RazdoruNET/DED_CORE_SPEAKER/README.md

# DED CORE SPEAKER — умная колонка и главная док-станция

Колонка на ESP32 с голосом ИИ-помощника «Лира»: микрофон, динамик, датчики,
ИК-пульт, шлюз для других умных устройств.

Документ описывает концепт и решения. Код прошивки — в [`firmware/`](./firmware),
план серверной части — в [`docs/03-server-plan.md`](./docs/03-server-plan.md)
(это план изменений в `src/AssistantService`, кода там ещё нет).

## Главное решение: колонка — тонкий терминал

Вся логика уже живёт на сервере: `AssistantService` умеет распознавать речь
(`VoiceTranscriptionService`), вести агента с инструментами (`AgentRuntime`),
синтезировать голос по фразам и отдавать его потоком (`speechChunk`), управлять
устройствами (`home.list` / `home.set`) и помнить человека. Колонке не нужен
свой интеллект — нужен качественный аудиотракт, wake word и надёжная связь.

Обратная сторона тоже верна: колонка **не должна умирать вместе с сервером**.
Поэтому целевая архитектура предусматривает три режима и переключение между ними.

## Три режима работы

| Режим | Кто «думает» | Что работает |
|---|---|---|
| **Автономный** | сама колонка | wake word + набор локальных команд, таймеры, будильники, громкость, ИК-пульт, Bluetooth-приёмник, локальные сценарии, ESP-NOW-датчики |
| **Агент** | сервер (`AssistantService`) | полный диалог, инструменты, память, управление платформой, ответ голосом потоком |
| **Сессия сайта** | браузер пользователя | колонка — это микрофон и динамик открытой вкладки: сайт ведёт разговор, колонка отдаёт звук в комнату |

Приоритет: **голосовой вызов → сессия сайта → агент → автономный**. Один владелец
звука одновременно; переключение — арбитром в прошивке
([`docs/01-architecture.md`](./docs/01-architecture.md)).

Сессия сайта важна отдельно: когда человек сидит за компьютером, второй интеллект
в колонке не нужен — она превращается в его микрофон и динамик, и голос Лиры звучит из
колонки, а не из ноутбука.

## Роль «главной док-станции»

Колонка — не просто колонка, а точка сбора умного дома:

* **ESP-NOW** — батарейные датчики (дверь, движение, температура) без Wi-Fi на каждом;
* **UART-модуль ESP32-H2** — Zigbee/Thread-координатор (вторая плата на том же корпусе);
* **ИК** — кондиционер, телевизор, вентилятор (приём и передача);
* **ммВолна LD2410C** — присутствие в комнате, без камеры;
* **MQTT-мост** — всё, что уже умеет говорить по MQTT.

Со стороны платформы колонка регистрируется как `IHomeDeviceProvider`, то есть
`home.list` и `home.set` работают с ней и её датчиками без изменения таблиц.

## Свет как язык агента

Лента — это низ лица агента: **уши (щёки)** и **рот**. 17 диодов буквой U
делятся по смыслу, а не поровну:

| Диоды | Что это | Роль |
|---|---|---|
| 1–3 и 15–17 | **уши** | индикация событий; ярче, когда колонка слышит звук |
| 4, 5 и 13, 14 | — | погашены всегда: граница между ухом и ртом |
| 6–12 | **рот** | двигается всегда — и в тишине, и во время речи |

Матрица глаз появится отдельной деталью, поэтому здесь только уши и рот.
Раскладка живёт в `firmware/src/app/LedLayout.h`.

**Рот двоичный и повторяет только голос агента.** В устойчивом виде диод либо
горит полностью, либо погашен; мягкость даёт только переход между формами.

- **Покой** — только средний диод: `0001000`.
- **Речь** — симметричные формы по центру под громкость:
  `0001000 → 0011100 → 0111110 → 1111111`.
- **Простой** — изредка (раз в 6–18 с) рот оживает: тройка диодов проезжает
  влево-вправо или пульсирует `010 → 111 → 010`.

**Шкалы микрофонов.** В простое лента показывает уровень каждого микрофона:
от диода 17 к центру — левый, от диода 1 к центру — правый. Чем громче канал,
тем длиннее шкала. Анимация речи рисуется поверх, поэтому она всегда главнее.

**Рот двигается всю речь агента.** Звук идёт либо из динамика колонки, либо из
браузера — во втором случае сервер присылает колонке огибающую той же записи,
поэтому рот работает и там, и там. Состояние «говорю» держится всю фразу,
включая паузы между слогами.

**Обращение видно сразу:** на слово-активатор вся лента на две секунды
загорается синим. Перед выполнением агент коротко отвечает голосом
(«Выполняю.») и только потом берётся за команду.

**Активация — только по слову-активатору.** Любой звук в комнате ленту не
меняет: колонка слышит постоянно, но при обращении вся лента вспыхивает синим
на две секунды, а дальше включается «слушаю». Приглушение эфира тоже
включается только здесь (`EVENT {kind:"wake"}`). Затем `thinking` — «думаю»,
и речь ответа.

**Рот повторяет реальный звук ответа**, от первого слова до последнего: когда
голос идёт из динамика — по уровню воспроизведения, когда из браузера — по
огибающей, которую сервер присылает событиями `EVENT {kind:"voice", v}`
25 раз в секунду.

**Уши — индикация событий.** В простое белое с пастельными переливами, в
раздумье бежит искра, у ошибки красное дыхание. Когда колонка слышит звук,
уши светятся тем ярче, чем громче голос.

| Состояние | Уши (1–3, 15–17) | Рот (6–12) |
|---|---|---|
| загрузка | белые точки с кончиков сходятся к центру | вспыхивает голубым огоньком |
| ждёт телефон | синие, плавное дыхание | тихое синее дыхание |
| ищу телефон | синяя искра от рта к виску | синее дыхание |
| **простой** | белое с пастельными переливами | спокойное дыхание |
| **слушаю** | бирюза, ярче с громкостью | `0001000`, без реакции на человека |
| **думаю** | фиолетовая искра по ушам | медленное фиолетовое дыхание |
| **говорю** | ровная зелень | форма по громкости, по центру |
| нет сервера | синяя искра по ушам | тлеет |
| ошибка | красное дыхание | тихое красное дыхание |
| звонок | стробоскоп | стробоскоп |
| микрофон выключен | красное дыхание | почти закрыт; перекрывает всё |

Ключевое правило: **выключенный микрофон перекрывает всё**. Человек должен
видеть это из любого угла комнаты, даже во время разговора.

Яркость ограничена 160 из 255: на 3.3 В полная яркость просаживает шину, и в
данные ленты начинают проскакивать ошибки — случайные цветные вспышки. После
перехода на 5 В с 74HCT125 яркость поднимается до 255.

Питание: лента подключена к **3.3 В** платы — так уровень данных ESP32
совпадает с лентой без согласователя. При яркости 220 из 255 17 диодов берут
около 0.45 А. Для полной яркости ленту питают от 5 В, а данные подают через
74HCT125 или диодную развязку (1N4148 + 1 кОм к +5 В).

**PSRAM выключена.** На этом ядре (Arduino 2.0.17 / IDF 4.4) связка «буферы TLS
в PSRAM + драйвер Wi-Fi» ломает память: колонка перезагружалась каждые 10–20
секунд. Без PSRAM — стабильная работа. Подробности и что поправить, чтобы
вернуть её: [`docs/05-firmware.md`](docs/05-firmware.md#почему-psram-выключена).

Для боевого `dedbox.pro` собирайте `esp32s3_dedbox`: сервер подписан
Let's Encrypt, и к CA платформы добавляется ISRG Root X2. Обычный `esp32s3`
остаётся для стенда с собственным CA.

## Железо: что выбрано и чего ждать

Основа — **ESP32-WROOM-DA** (классический ESP32, 520 КБ SRAM, без PSRAM).
Это рабочая база для прототипа: wake word (MicroWakeWord на TFLite Micro),
VAD, Opus, ИК, ESP-NOW, датчики — помещаются.

Не помещаются одновременно: аппаратный AEC (в esp-sr 2.x только S3+PSRAM),
декодирование музыки, дуплексный голосовой вызов. Подробный разбор с цифрами —
[`docs/04-hardware-bom.md`](./docs/04-hardware-bom.md). Прошивка пишется с
профилями `DA` и `S3`, чтобы переход на `ESP32-S3-WROOM-1 N16R8` был сборкой
другого env, а не переписыванием.

## Что лежит в папке

```
smart-speaker/
├── README.md                    этот файл: концепт и решения
├── LICENSE                      лицензия (некоммерческая, см. ниже)
├── LICENSE_EN                   то же на английском
├── docs/
│   ├── 01-architecture.md       слои, режимы, арбитр звука, топологии хаба
│   ├── 02-audio-protocol.md     бинарный WebSocket, кадры, кодеки, тайминги
│   ├── 03-server-plan.md        что добавить в AssistantService (файлы, ручки, конфиг)
│   ├── 04-hardware-bom.md       BOM, распиновка, питание, тепло, путь на S3
│   ├── 05-firmware.md           задачи FreeRTOS, бюджет памяти, состояния, OTA
│   ├── 06-roadmap.md            этапы, метрики приёмки, риски
│   ├── 07-pairing-security.md   первая синхронизация с аккаунтом, модель угроз
│   ├── 08-pairing-ux.md         сценарий привязки для человека
│   └── 09-production-security.md что обязательно сделать для серийной платы
├── firmware/                    PlatformIO-проект (собирается: pio run -e esp32da)
├── stl/                         файлы для 3D-печати корпуса колонки
└── tools/                       проверки протокола (векторы вывода ключа)
```

Локальный стенд (`.dev/` рядом с этим файлом; в основном репозитории —
`smart-speaker/.dev/`) и `firmware/src/config/Secrets.h` в публикацию не
входят: там приватные ключи, сертификаты и код привязки макета.
Правила — в `.gitignore` рядом с этим файлом.

## Два репозитория: платформа и колонка

Эта папка — копия содержимого отдельного репозитория изделия
[`RazdoruNET/DED_CORE_SPEAKER`](https://github.com/RazdoruNET/DED_CORE_SPEAKER):
там `smart-speaker/` лежит в корне. Правки прошивки и документации нужно
отправлять в оба, иначе версии расходятся — свежая прошивка остаётся в
платформе, а на странице изделия висит старая.

Как это делается здесь:

```bash
# 1. обычный коммит в основную платформу
git -C ~/Documents/GitHub/ded-core-platform commit ...

# 2. то же содержимое — в репозиторий колонки
rsync -a --delete \
  --exclude '.git' --exclude '.pio' --exclude '.DS_Store' \
  --exclude 'Secrets.h' --exclude '.dev' --exclude '.github' \
  smart-speaker/ /tmp/DED_CORE_SPEAKER/ && \
  git -C /tmp/DED_CORE_SPEAKER add -A && \
  git -C /tmp/DED_CORE_SPEAKER commit -m "..." && \
  git -C /tmp/DED_CORE_SPEAKER push origin HEAD:main
```

`.github` исключён намеренно: в репозитории изделия workflow обновляется
Dependabot, и копия из платформы откатила бы его назад.
`Secrets.h` и `.dev/` не попадают в git ни там, ни там — это правило
проверяет CI (`hygiene` в `security.yml`).

## Корпус: файлы для печати

В каталоге [`stl/`](./stl) лежат готовые к печати модели корпуса колонки —
здесь будут собраны **все** файлы, нужные, чтобы напечатать такой корпус
целиком (`Body2.stl` — основание/корпус; остальные детали добавляются по мере
готовности). Печатать в том же масштабе, что и модель (1:1, единицы —
миллиметры), без автоподгонки под стол принтера.

Что учесть при печати:

* материал — PETG или ASA: PLA рядом с усилителем и закрытым объёмом течёт
  уже при 55–60 °C;
* микрофоны встают на демпферы в верхней части корпуса, динамик — в
  ФИ-корпус с портом 25×60 мм; зазоры и посадки описаны в
  [`docs/04-hardware-bom.md`](./docs/04-hardware-bom.md);
* файлы — только геометрия, крепёж, экраны и прокладки в них не входят.

## Быстрый старт прошивки

```bash
cd smart-speaker/firmware
pio run -e esp32da            # сборка под ESP32-WROOM-DA
pio run -e esp32da -t upload  # прошивка
pio device monitor -b 115200

# Проверка усилителя MAX98357A и динамика без сети: три тона при старте
pio run -e esp32da_spk -t upload   # для esp32s3 — esp32s3_spk
```

Настройка — **только по Bluetooth, без точки доступа и без веб-интерфейса на
устройстве**. Своего фронта у колонки нет вовсе: настройка живёт на сайте
(Web Bluetooth), Wi-Fi и привязка приезжают в зашифрованном кадре. Это снимает
главное ограничение 4 МБ флеша и убирает целый класс уязвимостей «страница
настройки на устройстве».

Порядок: профиль → «ИИ Агент» → «Добавить колонку» → код с наклейки →
выбор колонки в списке Bluetooth → готово. Механика и модель угроз —
[`docs/07-pairing-security.md`](./docs/07-pairing-security.md).

## Состояние разработки

* **Версия прошивки — 0.2.3:** три встроенных слова-активатора, офлайн-набор
  домашней колонки и гоночная гарнитура отдельной сборкой `esp32s3_intercom`.
  В 0.2.2 закрыт откат версии кадра привязки, преролл сбрасывается при остановке
  захвата, а слабый голос больше не проходит проверку «по умолчанию».
  В 0.2.3 ограничена мощность Wi-Fi-передатчика: на слабом порту USB колонка
  больше не уходит в `BROWNOUT_RST` в момент подключения к сети.
* **Проверено на прототипе:** сборка и прошивка ESP32-WROOM-DA, стабильный
  идентификатор, ключ P-256 и криптосамопроверка, BLE-сервис, ручное окно
  сопряжения, RGB-состояния в коде, основы I2S/VAD.
* **Привязка проверена сквозным тестом на железе:** кадр шифруется независимой
  реализацией (ECDH → HKDF → AES-256-GCM), подпись сервера проверяется на
  устройстве, настройки сохраняются, подпись чужим ключом отвергается.
* **Сервер:** подпись grant, сущности `SpeakerDevices`/`SpeakerPairings`,
  миграция, ручки `pair/claim`, `devices`, `unbind`, `report-stolen`, `rename`
  и WebSocket `/api/assistant/speaker/stream` с fail-closed аутентификацией.
* **Защита сервера от открытого протокола:** лимит одновременных соединений
  (256 всего, 8 с адреса), 120 неудачных попыток HELLO в час с адреса, реальный IP за
  шлюзом (`UseForwardedHeaders`), сверка `pub` из `HELLO` с отпечатком привязки
  до выдачи `deviceKey`, закрепление отпечатка только после WSS-подключения.
* **Микрофон:** mute останавливает захват в прошивке и отбрасывается сервером;
  красная лента перекрывает любое состояние.
* **Безопасность канала:** колонка принимает только HTTPS/WSS и доверяет **только
  CA платформы** (`SPEAKER_ROOT_CA_PEM`), то есть сервер запинен. Публичные корни
  подмешиваются лишь флагом сборки `SPEAKER_ALLOW_PUBLIC_ROOTS=1` — вместе с ними
  доверие расширяется до любого публичного CA, и подделать сервер сможет тот, кто
  получит у него сертификат на наш домен (в HELLO уходит ключ устройства). Этот флаг —
  только для стенда. Если CA не задан, соединение блокируется намеренно; проверено
  на устройстве.
* **Встроенный набор и вариант устройства:** в прошивке есть таблица фраз
  домашнего устройства — три слова-активатора («Лира», «Джарвис», «Колонка») и
  две команды света («включи свет», «выключи свет»). Вариант
  (`SPEAKER_ROLE_HOME` / `SPEAKER_ROLE_INTERCOM`) задаётся при сборке. Гоночная
  гарнитура — отдельное изделие на общей базе: у неё своя сборка `esp32s3_intercom` и
  свой набор команд, команд света домашней колонки в нём нет. Пилот надевает её, чтобы
  в гонке не снимать руки с руля: голосом — зажигание и карты. Акустическое
  распознавание ещё не подключено, поэтому сейчас работают таблица и
  маршрутизация, а свет — заглушка без железа.
* **В разработке:** физическая сборка аудиотракта, стриминговый STT, звук по
  бинарному каналу.
* **Не реализовано:** wake word, Opus, датчики, ИК, OTA-клиент, локальные
  сценарии, автономное распознавание команд.
* **Остаточные риски** (привязка кадром версии 1 на устройстве без кода,
  нешифрованная NVS макета, перебор кода при утечке базы) перечислены в
  [`docs/07-pairing-security.md`](./docs/07-pairing-security.md), требования к
  серии — в [`docs/09-production-security.md`](./docs/09-production-security.md).

## Журнал изменений

### 0.2.3

* **Потолок мощности Wi-Fi 11 дБм.** Пиковый ток передатчика — главная нагрузка
  на шине 5 В. На слабом порту USB или длинном тонком кабеле просадка уходила
  ниже порога детектора, и колонка перезагружалась ровно в момент подключения к
  сети (`BROWNOUT_RST`), а вместе с перезагрузками терялись настройки в NVS.
  Потолок задаётся `SPEAKER_WIFI_TX_POWER` в `config/AppConfig.h`.
* **Стадии BLE-привязки пишутся в порт** (`[ble] стадия …`): окно привязки живёт
  пять минут, а причина отказа раньше была видна только в браузере.

### 0.2.2

* **Закрыт откат версии кадра привязки.** Версию теперь определяет сервер по
  записи устройства, она входит в подписанный grant, а сайт берёт её оттуда, а не
  из неаутентифицированной характеристики BLE. Подставное устройство больше не
  может навязать схему без кода с наклейки и прочитать пароль Wi-Fi.
  **Новая привязка требует прошивки 0.2.2:** старая каноническая строка grant
  изменилась.
* **Преролл сбрасывается при остановке захвата.** Голос агента из динамика больше
  не приклеивается к началу команды, а после mute на сервер не уходит звук,
  записанный при выключенном микрофоне.
* **Проверка голоса — эвристика, и теперь fail-closed.** Если голосовых кадров
  слишком мало, команда отклоняется, а не проходит «по умолчанию».
* **Образы DIY проверяются по SHA-256** до записи во флеш.
* **Зависимости:** `Microsoft.Data.Sqlite` 9.0.22 — закрыт GHSA-2m69-gcr7-jv3q.

### 0.2.1

* **Длинные фразы больше не теряются.** Раньше предел фразы считался по числу
  громких кадров, и в шумной комнате кусок растягивался на 20–40 с, а сервер
  выбрасывал всё длиннее 9 с. Теперь фраза ограничена по полному времени, а
  сервер обрезает слишком длинный фрагмент до последних секунд, а не удаляет.
* **«Чих» не запускает задачу ассистенту.** Детектор срабатывал на музыку, стук
  и хлопки; ответы на чих выключены по умолчанию (`Assistant:Speaker:SneezeReplies`).
* **Обращение распознаётся надёжнее.** Имя помощника и встроенные слова уходят в
  подсказки распознавания — в шуме они терялись первыми.
* **Детектор речи сбрасывается** при остановке захвата: после речи агента звук
  больше не склеивается с предыдущей фразой.

### 0.2.0

* **Три встроенных слова-активатора:** «Лира», «Джарвис», «Колонка».
* **Офлайн-набор домашней колонки:** две команды света («включи свет»,
  «выключи свет»); свет пока заглушка — реле и ламп в схеме нет.
* **Гоночная гарнитура — отдельное изделие** на общей базе прошивки: своя сборка
  `esp32s3_intercom` и образ `DED_CORE_INTERCOM_S3.bin`, домашних команд света
  в нём нет. Гарнитура нужна пилоту в гонке: руки на руле, голосом — зажигание
  и карты.
* **Сервер принимает встроенные обращения** наравне с именем профиля.
* Акустическое распознавание фраз ещё **не подключено**: работают таблица фраз
  и маршрутизация действий, проверить команды голосом нельзя.

### 0.1.0

* Привязка по BLE с кодом с наклейки.
* WSS с пином CA платформы.
* `HELLO`/`STATE` как основа протокола.
* Микрофон с VAD.
* Речь агента по `SAY`.
* Лента состояний.

## Лицензия

Прошивка, документация и описания протоколов распространяются по
некоммерческой лицензии из [`LICENSE`](./LICENSE) (English — `LICENSE_EN`):
личное и учебное использование разрешено, коммерческое — только с письменного
разрешения, производные версии — под той же лицензией. Это не OSI-лицензия.

## Что уже есть в платформе и переиспользуется

Пути в таблице — из основного репозитория платформы, здесь публикуется только
сама колонка; они показывают, какие серверные части уже готовы.

| Есть | Файл | Что даёт колонке |
|---|---|---|
| STT | `src/AssistantService/Services/Voice/VoiceTranscriptionService.cs` | распознавание фраз |
| TTS + поток по фразам | `SpeechStreamChunker.cs`, `LiveSpeechStream.cs` | первая фраза звучит до конца ответа |
| Агент | `Services/AgentRuntime.cs` | голос — ещё один клиент |
| Умный дом | `Services/Home/HomeContracts.cs` | `IHomeDeviceProvider` для колонки |
| OTA, ключи устройств | `src/FirmwareService` | обновление и привязка |
| Провижининг, LittleFS-фронт | `DED_CORE_V4-feature-ota-server-update/` | те же паттерны настройки |

Не переиспользуется только одно: **SignalR-хаб** (`speechChunk` идёт текстом JSON).
Для колонки нужен отдельный бинарный WebSocket — JSON-обёртка на каждый 20-мс
аудиокадр съедает и канал, и RAM. Обоснование — в
[`docs/02-audio-protocol.md`](./docs/02-audio-protocol.md).
