RazdoruNET/DED_CORE_SPEAKER/docs/05-firmware.md

# Прошивка

Проект — [`firmware/`](../firmware), PlatformIO, фреймворк Arduino (как в
`DED_CORE_V4`, чтобы переиспользовать провижининг, NVS и OTA-паттерны).

```
firmware/
├── platformio.ini
└── src/
    ├── main.cpp
    ├── config/AppConfig.h        пины, лимиты, профиль платы
    ├── proto/Protocol.h          кадры: типы, сборка/разбор (заголовочный)
    ├── audio/AudioPipeline.*     I2S вход/выход, преролл, VAD, оценка уровня
    ├── net/DeviceConfig.*        NVS: Wi-Fi, ключ устройства, сервер
    ├── net/DeviceIdentity.h      id устройства из MAC (он же на наклейке)
    ├── net/PairingCrypto.*       ключ P-256, расшифровка кадра привязки
    ├── net/BlePairing.*          GATT-сервис привязки и окно видимости
    ├── net/WifiLink.*            подключение к домашней сети, backoff
    ├── net/SpeakerLink.*         WS-клиент, протокол, состояние связи
    ├── app/AudioArbiter.*        кто владеет микрофоном и динамиком
    ├── app/Ui.*                  LED, кнопки, жесты
    ├── app/LedLayout.h           раскладка ленты по низу колонки (U)
    ├── app/Role.h                вариант устройства: домашняя колонка или гоночная гарнитура
    ├── app/LocalCommands.*       встроенный офлайн-набор фраз этого варианта устройства
    └── app/Intents.*             локальные команды и таймеры без сервера
```

## Задачи FreeRTOS

| Задача | Ядро | Приоритет | Стек | Что делает |
|---|---|---|---|---|
| `mic_task` | 1 | 10 | 4096 | I2S DMA → кадр 20 мс → преролл → VAD → очередь вверх |
| `wake_task` | 1 | 8 | 6144 | MFCC + TFLM каждые 20 мс по 0.6 с окну |
| `uplink_task` | 0 | 6 | 4096 | Opus-энкод + отправка кадров `MIC` |
| `downlink_task` | 0 | 7 | 6144 | приём кадров, джиттер, Opus-декод → I2S |
| `link_task` | 0 | 5 | 4096 | Wi-Fi/WS/BLE: состояние, ping, реконнект, привязка, OTA |
| `app_task` | 1 | 3 | 4096 | автомат, LED, кнопки, таймеры, ИК |

Почему именно так: аудио и wake word на одном ядре (метки времени I2S не
пересекаются с сетевыми всплесками), а сеть и декод — на втором. Классический
ESP32 без PSRAM не прощает копирования больших буферов — все передачи через
указатели и фиксированные пулы, ни одного `std::string` в аудиотракте.

## Состояния

```
BOOT → PAIRING (нет Wi-Fi/ключа, окно привязки) ──кадр принят──► перезагрузка → IDLE
IDLE ──wake word / кнопка──► LISTENING
LISTENING ──тишина 400 мс──► THINKING
THINKING ──первый кадр SAY──► SPEAKING
SPEAKING ──SPEECH_END──► IDLE
SPEAKING ──"стоп" / barge_in──► IDLE (поток закрыт)
Любое ──потеря связи──► OFFLINE (локальные умения) ──связь──► IDLE
Любое ──CMD intercom.incoming──► INTERCOM
```

Строка `THINKING` живёт не дольше `MaxDeviceSeconds` (30 с). Дольше — колонка
говорит заранее синтезированной фразой «сервер не отвечает» и уходит в `IDLE`,
а не висит в тишине.

## Тайминги, зашитые в прошивку

| Параметр | Значение | Почему |
|---|---|---|
| кадр I2S | 20 мс | совпадает с Opus-кадром, нет перепаковки |
| преролл | 0.9 с | wake word срабатывает с задержкой — начало фразы не должно потеряться |
| тишина до конца фразы | 400 мс | 900 мс (как в браузере) колонка воспринимает как «тупит» |
| минимальная фраза | 250 мс | короче — это кашель, а не команда |
| джиттер вниз | 3 кадра | 60 мс, дальше слышны провалы |
| ping | 15 с | дешевле, чем ловить зависший TCP по таймауту ответа |
| реконнект | 2 с → ×2 → 60 с | не долбить сервер при массовом отключении питания |

## NVS (namespace `spreaker`)

| Ключ | Тип | Смысл |
|---|---|---|
| `wifi_ssid` / `wifi_pass` | string | сеть |
| `api_base` | string | адрес платформы (`https://api...`) |
| `device_key` | string | ключ из профиля, вводится кодом привязки |
| `name` / `room` | string | «Колонка», «Гостиная» |
| `volume` | u8 | 0–100 |
| `mute` | bool | тумблер + софт |
| `rules_ver` | u32 | версия локальных сценариев |
| `rules` | blob | до 4 КБ — сценарии автономного режима |
| `ir_codes` | blob | обученные ИК-коды |
| `timer_*` | u32 | активные таймеры и будильники |

Ничего, что меняется чаще раза в минуту, в NVS не пишется: у ESP32 флеш
изнашивается, а `Preferences.put*` на каждом кадре убил бы её за месяцы.
Громкость пишется с задержкой 5 с после последнего изменения.

## OTA

Два слота по 1.4 МБ, `otadata` выбирает активный. Обновление — через
`FirmwareService`, тот же путь, что у DED CORE V4:

1. `EVENT {kind:"ota.available", version, url, sha256}` или ручка
   `POST /api/update` при провижининге;
2. скачивание в неактивный слот по HTTPS с проверкой SHA-256;
3. `esp_ota_set_boot_partition` + перезагрузка;
4. если после перезагрузки нет `HELLO_ACK` 3 раза подряд — откат на прежний слот
   (`esp_ota_mark_app_invalid_rollback_and_reboot`).

Ключевое отличие от DED CORE: **нельзя** обновляться, пока идёт разговор.
`link_task` дожидается `IDLE` или прерывает разговор честной фразой.

### Версии

Текущая версия — **0.2.2** (`SPEAKER_FIRMWARE_VERSION` в `config/AppConfig.h`),
она же уходит в `HELLO`. В 0.2.2 закрыт откат версии кадра привязки, сбрасывается
преролл и ужесточена проверка голоса; в 0.2.1 исправлены длинные фразы и ложные
ответы на чих. В 0.2.0 вошли три встроенных слова-активатора
(«Лира», «Джарвис», «Колонка»), офлайн-набор домашней колонки с двумя командами
света, гоночная гарнитура отдельной сборкой `esp32s3_intercom` и приём встроенных
обращений на сервере наравне с именем профиля. Акустическое распознавание фраз
ещё не подключено: работают таблица и маршрутизация, свет — заглушка.

## Привязка по Bluetooth (единственный способ настройки)

Фронта на устройстве нет. Первый запуск без сети:

1. колонка генерирует пару P-256 и кладёт в NVS (закрытый ключ наружу не уходит
   никогда — наружу идёт только открытый, 65 байт);
2. открывается окно привязки на 5 минут: BLE-реклама с сервисом
   `6b1f0001-…`, имя `DED-SPEAKER-<id>`;
3. сайт читает `info` и передаёт открытый ключ серверу вместе с кодом с
   наклейки; сервер сверяет его с уже закреплённым отпечатком (если он есть),
   выдаёт подписанный grant. Сайт шифрует настройки (ECDH → HKDF → AES-256-GCM)
   кодом кадра, который сообщила колонка: версия 2 — с кодом с наклейки в метке
   HKDF, версия 1 — без него (макет) — и пишет кадр в `pair` кусками по 240 байт;
4. колонка расшифровывает, сохраняет Wi-Fi и одноразовый `pairToken`, гасит BLE
   и перезагружается;
5. `HELLO {token, pub}` → сервер сверяет `pub` с отпечатком привязки, меняет
   токен на долговременный `deviceKey` и закрепляет отпечаток за устройством.

Код привязки в серии лежит в NVS (`spk_id/code`), на макете его можно задать
через `SPEAKER_PAIR_CODE` в `Secrets.h`. С прошитым кодом колонка принимает
только кадр версии 2 и сообщает её полем `frame` в BLE `info`; формула вывода
ключа закреплена векторами в
[`tools/pairing-kdf-check.py`](../tools/pairing-kdf-check.py). Зачем именно так
— [`07-pairing-security.md`](./07-pairing-security.md), серийные требования —
[`09-production-security.md`](./09-production-security.md).

Окно привязки открывается **только по действию человека**: удержание кнопки
5 с. При первом запуске рекламы нет — лента медленно пульсирует синим, пока
человек не нажмёт кнопку. После успеха BLE выключается. Повторная привязка
уже сопряжённой колонки запрещена прошивкой; сначала требуется отвязка
в профиле на сайте. Механика и модель угроз —
[`07-pairing-security.md`](./07-pairing-security.md).

## Микрофон и mute

Выключенный микрофон обязан выключать именно микрофон, а не только ленту:

* `syncMute()` в главном цикле считает состояние из двух источников —
  `deviceConfig.muted` (программный mute) и физического переключателя
  `SW_MUTE`; переключатель читается с подавлением дребезга (три одинаковых
  отсчёта с шагом 20 мс), потому что на профиле DA это GPIO36 без внутренней
  подтяжки и на плате нужен внешний резистор вверх;
* пока mute активен, `audioPipeline.stopCapture()` останавливает захват:
  кадры `MIC` не формируются и на сервер не уходят вовсе;
* переключение отправляется событием `EVENT {kind: muted|unmuted}` и полем
  `muted` в `HELLO`/`STATE`; сервер дополнительно отбрасывает кадры `MIC`,
  пока считает микрофон выключенным — «выключено» не должно зависеть от
  версии прошивки на устройстве;
* лента в этом состоянии красная и перекрывает любое другое состояние.

Стек BLE занимает ~250 КБ флеша и 30–45 КБ RAM. Флеш-бюджет это выдерживает
(прошивка 72 % слота). После привязки BLE-реклама останавливается; полный
выгруз стека пока не реализован.

Выходной тракт выбирается флагом: по умолчанию внешний I2S-ЦАП или I2S-усилитель
(`pio run -e esp32da`), а `pio run -e esp32da_dac` направляет звук во встроенный
8-битный ЦАП ESP32 на GPIO25 — микрофон при этом переезжает на I2S1, потому что
встроенный ЦАП живёт только на I2S0. Стендовая сборка для проверки привязки без
кнопки — `pio run -e esp32da_bench`; в релиз она не входит.

Проверить усилитель и динамик, не поднимая сеть, — `pio run -e esp32da_spk`
(или `esp32s3_spk`): при старте в I2S уходят три тона 440, 1000 и 2000 Гц,
пищалка молчит. В логе видны строки `[spk] проверка выхода…`. Сборка стендовая,
в релиз не входит; распиновка — в
[`04-hardware-bom.md`](./04-hardware-bom.md#подключение-max98357a-один-динамик-4-ω).

WSS включается только при наличии доверенного CA в локальном
`config/Secrets.h`. Пустой CA — безопасный отказ с сообщением в Serial, без
попытки подключиться с отключённой проверкой сертификата. Без этого файла
устройство не должно отправлять сеть или pairing token на сервер. Для локального
стенда скопируйте `config/Secrets.example.h` в `config/Secrets.h` и замените
placeholder действительным PEM CA сертификатом.

## Локальные умения (`Intents`)

Работают без сервера:

* таймер / будильник / «сколько осталось»;
* громкость, mute, «стоп»;
* ИК-сценарии: «кондиционер 23», «телевизор громче» — коды учатся с пульта и
  хранятся в NVS;
* ESP-NOW: чтение датчиков и подача команд реле;
* локальные правила: «движение в коридоре → включить свет» (порог и действие в NVS).

Распознавание локальных команд — **keyword spotting**, а не STT: 20–30 фраз,
модель на TFLite Micro. Это принципиально: полноценный STT на 520 КБ SRAM без
PSRAM не живёт.

## Вариант устройства и встроенный офлайн-набор

Домашняя колонка и гоночная гарнитура — два разных устройства на общей базе прошивки.
Колонка остаётся домашним устройством, а DED CORE INTERCOM — гоночная гарнитура: её надевает
пилот, чтобы в активной гонке не снимать руки с руля, и голосом управляет блоком зажигания и
переключает карты. Вариант устройства выбирается при компиляции, а не приходит с сервера:
`SPEAKER_ROLE_HOME` — домашняя колонка, `SPEAKER_ROLE_INTERCOM` — гоночная гарнитура
(`app/Role.h`). Набор фраз — часть продукта: если бы вариант приходил по сети, один и тот же
образ можно было бы превратить в другое устройство, а таблица фраз утекла бы вместе с
прошивкой. Плюс автономные команды обязаны работать без сети, поэтому набор должен быть
известен уже на этапе сборки. Обе сборки домашней колонки, `esp32s3` и `esp32da`, задают
`SPEAKER_ROLE_HOME=1`; гарнитура — отдельное изделие со своей сборкой `esp32s3_intercom` и
своим образом `DED_CORE_INTERCOM_S3.bin`.

Встроенный набор домашнего устройства лежит в `app/LocalCommands.*`:

| Слова-активаторы | Команда | Действие |
|---|---|---|
| «Лира», «Джарвис», «Колонка» | «включи свет» | `Intents::lightOn()` |
| «Лира», «Джарвис», «Колонка» | «выключи свет» | `Intents::lightOff()` |

В таблице шесть строк — три имени на два действия; фраза записана вместе с
обращением. Сравнение идёт без учёта регистра, кириллица приводится к нижнему
регистру с учётом UTF-8.

**Честно о состоянии.** Акустическое распознавание к таблице ещё не подключено:
сейчас работают только сама таблица и маршрутизация действий, поэтому проверить
команды голосом нельзя. Свет — заглушка: `Intents::lightOn()` и
`Intents::lightOff()` пишут строку в журнал, играют короткое подтверждение
пищалкой и, если есть связь, отправляют событие `local.light.on` /
`local.light.off` на сервер. Реле и лампы в схеме нет — управлять пока нечем.

У гоночной гарнитуры таблица пуста: `localCommands()` возвращает `nullptr` и ноль
записей, а `isBuiltInWakeWord()` всегда отвечает `false`. Прикладные команды гарнитуры —
зажигание, карты, сценарии гонки — появятся в её прошивке отдельным слоем; домашние имена
в неё не попадают.

## Что проверяется на устройстве

| Проверка | Как |
|---|---|
| Задержка wake → первый звук | счётчик в прошивке печатает мс в лог |
| Потери кадров | `seq` вниз, раз в 10 с в `STATE` |
| Heap watermark | `esp_get_free_heap_size()` минимум за сессию, в `STATE` |
| Троттлинг | температура кристалла, порог 75 °C |
| Реконнект | выдернуть Wi-Fi роутер на 2 минуты, разговор должен восстановиться |
| Откат OTA | залить заведомо сломанную прошивку в неактивный слот |
| Привязка целиком | Chrome: «Добавить колонку» → код с наклейки → кадр → перезагрузка → `HELLO_ACK` |
| Подмена в эфире | подключиться к колонке телефоном с чужим ключом: `decrypt` должен отказать |
| Язык ленты | каждое состояние видно с 3 м, mute перекрывает любое |
| Крипто-путь | самопроверка на старте: ECDH → HKDF → AES-GCM, `[crypto] ок` |
| Видимость BLE | сканер видит сервис `6b1f0001-…`, `local_name = DED-SPK-<4 hex>` |
| Привязка целиком по BLE | проходит: `stage: paired`, настройки в NVS, перезагрузка |
| Подпись чужим ключом | отвергается: `stage: error, error: grant_signature` |
| WSS без CA | отказ до соединения: `[ws] TLS CA не настроен` |

### Что нашлось только на железе

Три ошибки, каждая из которых ломала привязку целиком и не видна в тестах:

1. **`NimBLECharacteristic::setValue(const char*)` не существует.** Есть только
   `setValue(const uint8_t*, size_t)` и шаблон `setValue<T>(const T&)`, который
   записывает сырые байты типа. Для `const char*` это 4 байта **указателя**:
   характеристика `info` отдавала мусор вместо JSON. Правильно —
   `setValue(reinterpret_cast<const uint8_t*>(s.c_str()), s.length())`.
2. **ArduinoJson с `char*` разбирает на месте.** Документ хранит указатели в
   исходный буфер, поэтому затирание `plain` сразу после разбора превращало все
   строки в пустые — проверка grant падала на «нет полей». Затирание секретов
   перенесено после копирования нужных значений в `String`.
3. **Буферы были малы.** Полезная нагрузка с grant — 638 байт JSON; `plain[512]`
   и `DynamicJsonDocument(384)` её не вмещали. Сейчас `plain[900]`,
   документ 1024, кадр 1024.

### Что нашлось при первом запуске на ESP32-S3

Плата ESP32-S3 DevKitC-1 N16R8 пришла с завода; два дефекта проявились сразу.

**1. Прошивка не загружалась вообще — цикл перезагрузки без сообщений.**

Определение платы `esp32-s3-devkitc-1` в PlatformIO описывает **N8: 8 МБ
флеша и без PSRAM**, а модуль — N16R8. Загрузчик считал флеш
восьмимегабайтным, таблица разделов доходила до 16 МБ, и он молча
перезагружался, не печатая даже баннера. Лечение — объявить возможности
явно:

```ini
board_upload.flash_size = 16MB
board_build.flash_mode = qio
board_build.arduino.memory_type = qio_opi
```

Проверка после сборки: байт 3 в заголовке образа кодирует режим и размер
флеша. Было `0x3F` (8 МБ), стало `0x4F` (16 МБ).

**2. После загрузчика — паника `Double exception` в `applog::begin()`.**

Причина — **повторная инициализация UART0** через `Serial0.begin(115200)` при
включённом `ARDUINO_USB_CDC_ON_BOOT`. Ядро в этом режиме уже поднимает UART0,
и второй `begin()` для того же порта роняет его переполнением стека внутри
`uartBegin`. Точка падения была видна только по символизированной цепочке:
`applog::begin()` рядом с `_xt_alloca_exc`.

Решение: UART0 больше не трогаем, а дублируем логи через ROM-консоль —
она настроена загрузчиком на 115200 и драйвера не требует:

```cpp
esp_rom_printf("%s", chunk);
```

Порциями по 128 байт: у ROM-printf свой буфер, а строки бывают длиннее.

**Заодно нашлась третья мелочь:** буфер `applog::printf` был 256 байт, а JSON
с открытым ключом устройства — около 450. Строка обрезалась ровно посередине
ключа, и сайт не смог бы собрать запрос на привязку. Буфер увеличен до 512.

После исправлений на S3:

```
=== DED CORE SPEAKER 0.2.0 (esp32s3) ===
[boot] устройство 7CE8B1B063DC, свободно 302216 байт
[crypto] самопроверка привязки: ок
[ble] окно привязки открыто: {"id":"7CE8B1B063DC", ... ,"challenge":"..."}
```

Флеш 16 777 216 байт, PSRAM 8 МБ, приложение занимает 1.14 МБ из 3 МБ слота.

Отдельно: **разбор PEM в предсборке mbedtls может быть выключен**, поэтому
открытый ключ подписи закрепляется как несжатая точка P-256 в hex
(`SPEAKER_PAIRING_PUBLIC_KEY_HEX`, 130 символов), а проверка идёт через
`mbedtls_ecdsa_read_signature`. С PEM проверка молча отказывала бы всегда.

## Тракт микрофона: что настроено и почему

Все константы — в `src/config/AppConfig.h`, тракт целиком — в
`src/audio/AudioPipeline.cpp`.

| Что | Значение | Почему так |
|---|---|---|
| Частота | 16 кГц, кадр 20 мс (320 отсчётов) | формат распознавателя; кадр совпадает с шагом отправки |
| Отсечка инфразвука | Баттерворт 4-го порядка, 90 Гц | в комнате гул 40–60 Гц уровня речи; один полюс гасил его лишь на 7 дБ |
| Усиление | ×8 (18 дБ) с мягким ограничителем от 22 000 | речь с двух метров давала −36 dBFS, распознаватель ждёт около −20 |
| AGC | цель 5200 RMS, подъём до ×5, только выше 2× фона | тихая фраза доходит до распознавателя той же громкостью, что и громкая |
| Детектор речи | 700 / 380 по RMS плюс 2.4× / 1.8× над фоном | прежние 1300/650 и 5× фона не пропускали спокойную речь в комнате с вентилятором |
| Пауза конца фразы | 600 мс | 400 мс обрывали фразу на естественной паузе |
| Преролл | 900 мс | начало слова не теряется |

### Почему колонка слышала только громкую речь

Три причины складывались:

* **Порог фона считался средним.** Вентилятор, улица или разговор в соседней
  комнате поднимали оценку на минуты, и порог «2.4× фона» уходил выше речи.
  Теперь фон — минимум в окне 200 мс, сглаженный за пару секунд: это именно
  тишина комнаты, а не её средний шум.
* **Запас над фоном был 5×** (14 дБ). Живой замер: фон 300–600, спокойная речь
  с двух метров 900–1400 — такая речь не проходила вообще. Стало 2.4× (7.6 дБ).
* **Фиксированный порог 1300** был выше тихой речи. Стал 700, а от ложных
  срабатываний защищает адаптивная часть.

Дополнительно появился AGC: он поднимает тихую фразу до целевого уровня перед
отправкой, поэтому распознаватель получает одинаковую громкость и с двух
метров, и с пяти. AGC включается только когда сигнал выше 2× фона — иначе он
усилил бы саму тишину. Пороги VAD считаются по сигналу **до** AGC, поэтому
чувствительность не «плавает» вместе с усилением.

Диагностика: в строке `[heap]` печатаются `шум` и `порог`. Если `порог` выше
`rms` при спокойной речи — колонка её не слышит, и видно, какая из величин
виновата.

Проверка без единого звука: сборка `esp32s3_selftest` подменяет отсчёты
микрофона эталонным тоном 1000 Гц (в динамик он не идёт). Тон приходит на
сервер ровно на 1000 Гц, вспышка 2 с — записью 1.86–2.02 с. Так проверяются
кадры, их темп и разметка частоты, не мешая окружающим.

Обращение к колонке попадает в подсказку распознаванию
(`Assistant:Speaker:WakeWord`, по умолчанию «Колонка»): без него движок
слышит «Колонка, проверка звука» как «Ланка проека звука».

### Обрывы защищённого соединения

Отправка звука идёт не чаще реального времени (один кадр в 20 мс), иначе
преролл выстреливает десятками кадров за один проход `loop()`, mbedTLS не
успевает отправить буфер и отдаёт `-27648` (`SSL - Internal error`), а поток
WebSocket теряет синхронизацию. Если связи нет дольше 30 с, клиент
пересоздаётся, а на второй попытке переподключается Wi-Fi: при «залипшем»
TCP библиотека иначе повторяет SYN до бесконечности.

## Слух при играющей музыке

Колонка слушает комнату, а рядом играет радио из браузера — микрофон слышит те же
колонки компьютера. Эхоподавления на устройстве нет, поэтому договорились так:

* **порог детектора речи адаптивный**: оценка шума поднимается за секунду
  (`delta/64`), поэтому ровный эфир порог не пробивает — колонка ждёт обращение
  поверх музыки, а не шёпот;
* **слух не выключается**: прежний вариант «молчать, пока играет звук» убивал
  возможность услышать кодовое слово;
* **эфир приглушается, а не выключается**: как только колонка начала слушать, она
  сообщает об этом серверу, а сервер — открытой вкладке; вкладка уводит эфир и
  видео до четверти громкости и возвращает звук после конца фразы.

Отдельные правила поверх этого:

| Что | Как ловится |
|---|---|
| Обращение | имя помощника из профиля, сравнение по Левенштейну (1–2 буквы разницы) |
| Голос хозяина | высота тона против эталона из профиля, допуск 0.6 октавы |
| Чих | всплеск 80–360 мс с пиком ≥ 4000, за которым идёт пауза 800 мс |
| Музыка/гул | длинный фрагмент (>9 с) на сервер не уходит вовсе |

## Почему PSRAM выключена

На живой колонке с включённой PSRAM (N16R8, OPI) устройство жило секунды:

```text
[ws] dedbox.pro:443/api/assistant/speaker/stream
Guru Meditation Error: Core 0 panic'ed (LoadProhibited)
  → sta_input → esf_buf_alloc → tlsf_malloc (сломанные списки кучи)
```

То же самое повторялось на прошивке из репозитория без наших правок, то есть
дефект не в приложении. Без PSRAM — четыре минуты непрерывной работы и ни
одного сбоя; с ней — перезагрузки каждые 10–20 секунд.

Причина в связке «крупные буферы TLS в PSRAM + драйвер Wi-Fi» на этом ядре
(Arduino 2.0.17 / IDF 4.4): сессионные буферы mbedTLS больше 16 КБ уходят во
внешнюю память, и дальше куча разъезжается. Поэтому `esp32s3` собирается с
`memory_type = qio_qspi` без `BOARD_HAS_PSRAM`, а PSRAM осталась отдельным
env `esp32s3_psram` — её включать только вместе с переходом на ядро Arduino 3.x
и нагрузочным прогоном.

Заодно поправлено:

* **сокет живёт в своей задаче** (`wsLoop`, 8 КБ стека). Раньше
  `WebSocketsClient::loop()` вызывался из главного цикла, и рукопожатие TLS
  (5–7 с) останавливало ленту, кнопки и очередь микрофона;
* **проверка целостности кучи убрана из рабочей сборки**:
  `heap_caps_check_integrity_all()` обходит кучу без блокировки, а рядом Wi-Fi и
  I2S постоянно что-то выделяют — обход видит половину обновлённого списка,
  объявляет живую кучу испорченной и перезагружает плату. Включается только
  флагом `-DSPEAKER_HEAP_AUDIT=1` и не чаще раза в 2 секунды;
* **повтор подключения с ростом паузы** 2 → 4 → 8 → 16 → 30 с: раньше при
  недоступном сервере колонка устраивала рукопожатие TLS каждые две секунды.

## Светодиодная лента

Лента — 17 диодов WS2812B по низу колонки буквой U. По смыслу это низ лица
агента: **уши (щёки)** и **рот**, разделённые погашенными диодами.

```
1 2 3 | 4 5 | 6 7 8 9 10 11 12 | 13 14 | 15 16 17
 уши    выкл.       рот            выкл.     уши
```

| Диоды | Часть | Роль |
|---|---|---|
| 1–3 и 15–17 | уши | индикация событий и отклик на звук |
| 4, 5 и 13, 14 | разделители | погашены всегда: граница уха и рта |
| 6–12 | рот | живёт всегда: форма по громкости речи агента |

Раскладку задают `LED_EAR_LEDS`, `LED_GAP_LEDS` и `LED_MOUTH_LEDS` в
`config/AppConfig.h`, а геометрию — `app/LedLayout.h`. Цепочка: `0..2` — левое
ухо (от виска к рту), `3..4` — разделители, `5..11` — рот, `12..13` —
разделители, `14..16` — правое ухо. Если лента смонтирована наоборот, включите
`leds::kReversed`.

Рот **двоичный**: в устойчивом виде диод либо горит полностью, либо погашен.
Мягкость даёт только переход между формами — яркость подтягивается к цели за
3–4 кадра и «щёлкает» в 0 или 255, когда разница мала. В покое полусветов нет.

**Покой** — единственный средний диод: `0001000`.

**Речь** — симметричные формы по центру, по громкости голоса агента:

```
0001000 → 0011100 → 0111110 → 1111111
```

Пороги: до 45 — `0001000`, от 45 — `0011100`, от 90 — `0111110`, от 140 —
`1111111`. В паузах между словами рот возвращается в `0001000`.

**Простой** — изредка, с разными длинными паузами (6–18 с), рот «оживает»:

* по рту проезжает тройка диодов влево и обратно (`1110000 … 0000111`);
* тройка в центре пульсирует `010 → 111 → 010`;
* после — снова только средний диод.

Разделители (4, 5, 13, 14) не зажигаются ни в одной сцене, включая стробоскоп
и включение. Единственное исключение — двухсекундная вспышка по обращению: там
горит вся лента, потому что это событие, а не лицо.

Кадр начинается с очистки ленты. Без этого диод, зажжённый в прошлом кадре,
остаётся горящим: шкалы микрофонов не спадали в тишине, а цвета разных
состояний наслаивались друг на друга.

Яркость 160 из 255. На 3.3 В и полной яркости лента берёт почти ампер, шина
просаживается, и в данные проскакивают ошибки — со стороны это выглядит как
случайные цветные вспышки. После перехода на 5 В с 74HCT125 яркость можно
поднимать до 255 (`SPEAKER_LED_BRIGHTNESS`).

**Шкалы микрофонов.** В простое и в состоянии «слушаю» лента работает как два
индикатора уровня: от диода **17 к центру** растёт левый микрофон, от диода
**1 к центру** — правый. Чем громче канал, тем больше диодов загорается; крайний
диод шкалы ярче остальных. Шкалы — это фон: рот, события и вспышка рисуются
поверх, поэтому анимация речи всегда главнее индикации микрофона.

Шкала логарифмическая: `50` RMS — ноль делений, `3000` — все восемь. Линейная
шкала врала: обычный разговор давал одно деление из восьми, а крик в упор —
только половину. Ориентиры: шёпот ≈ 100 (1 деление), разговор с метра ≈ 400
(3), громкая речь ≈ 1000 (5), голос в упор ≈ 1500–2500 (6–7).

**Речь агента двигает рот в любом случае.** Звук может идти из динамика
колонки (кадры `SAY`, уровень считается по проигранным отсчётам) или из
браузера. Во втором случае колонка этого звука не слышит, поэтому сервер
считает огибающую той же записи и присылает её событием
`EVENT {kind:"voice", v, active}` 25 раз в секунду. `active` держит состояние
«говорю» всю фразу, включая паузы между слогами: без него рот падал бы в простой
на каждой запятой. Когда `active` становится 0 и звук кончился, колонка
возвращается в простой.

**Обращение подтверждается вспышкой.** Как только сервер распознал слово-
активатор (`EVENT {kind:"wake"}`), вся лента на две секунды загорается синим —
включая разделители и рот. Это событие, а не лицо, поэтому оно перекрывает
любую анимацию. Дальше идёт «слушаю», затем «думаю» и «говорю».

**Перед выполнением агент отвечает голосом.** Сразу после распознавания
команды сервер присылает короткое подтверждение и только потом запускает работу:
несколько секунд тишины человек читает как «не услышала». Фраза каждый раз
разная — «Секунду.», «Моментик.», «Момент.», «Сейчас.», «Одну секунду.» — иначе
одно и то же слово звучит как автоответчик: набор задаёт
`Assistant:Speaker:AckVariants`. У конкретного голоса может быть свой набор:
`Assistant:Speaker:AckTexts` — словарь «голос → фразы через |»; голоса, которого
там нет, берут общий список.

**Ответ звучит оттуда, где выбран вывод.** Настройка профиля
`outputDevice` (`auto` | `speaker` | `browser`, по умолчанию `auto`) решает, кто
говорит: колонка или динамики компьютера. `auto` — колонка, если она в сети,
иначе браузер. При `speaker` сервер отдаёт устройству кадры `SAY` по ходу
генерации, а браузеру в ответе на синтез ставит заголовок `X-Speaker-Audio: 1`;
по нему браузер молчит, иначе одну реплику произносили бы два голоса. Фразы
встают в очередь устройства и звучат по порядку: раньше вторая реплика молча
терялась, и в ответе пропадали слова.

Куски, которые уже ушли в колонку из потока, сервер помнит минуту: браузер
просит синтез для каждого куска, и без этой памяти устройство прочитало бы
фразу дважды. Приветствие и подсказки инициативы идут только браузерным путём —
их колонка получает из того же запроса синтеза.

**Радио и музыка звучат с самой колонки.** Устройство декодирует MP3 (minimp3,
public domain) в PCM и отдаёт его в I2S на 44.1 кГц стерео — качество
ограничено только станцией. Путь через браузер (кадры `SAY`, PCM16 16 кГц моно)
оставлен речи: музыка в нём звучит как телефон.

Сам поток тянет **сервер** и отдаёт его кадрами `MEDIA` по уже открытому каналу.
Плата пробовала качать сама — не выходит: при живом TLS-канале к платформе на
второй сокет не остаётся непрерывной памяти. В логе это `станция не ответила,
код -7` и `heap 3304` сразу перед перезагрузкой, то есть человек слышал
«включил радио» и тишину.

| Что | Как |
|---|---|
| команда | `CMD {action:"media.stream", args:{title}}` (поток с сервера), `media.play` (устройство тянет само — только стендовые сборки) и `media.stop` |
| формат потока | MP3 44.1 кГц стерео: 1 КБ кадра — 64 мс звука |
| речь важнее | на `SPEECH_BEGIN` эфир замирает: задача декодера отпускает I2S и выбрасывает накопленное, чтобы после ответа зазвучало «сейчас». Возвращает эфир сервер — новой командой `media.stream` |
| громкость | `MEDIA_GAIN_PERCENT` от громкости речи (сейчас 50%): станции сведены с полной шкалой и перекрывали ответы |
| низ | низкая полка +8 дБ ниже 120 Гц: у динамика в корпусе своего низа нет |
| AAC | не поддерживается: каналы Radio Record (`.aacp`) остаются браузеру |
| «молчит» | сторож речи: если `SPEECH_END` потерялся, через 20 секунд без звука флаг «говорю» снимается сам и слух возвращается. В строке `[state]` видно `захват`, `агент говорит`, `эфир`, `приём` и `буфер` |

**Память — самый тесный ресурс.** С открытым TLS-каналом к платформе свободно
около 60 КБ, и эфиру нужно 35. Отсюда правила, которые нельзя нарушать:

* буферы декодера выделяются один раз при старте платы, до Wi-Fi и TLS: позже
  в куче уже нет цельного куска на шесть килобайт;
* предбуфер обязан влезать во входной буфер декодера (сейчас 6 КБ в 8 КБ) —
  иначе условие «накопили достаточно» не выполнится никогда, декодер будет
  ждать вечно, а буфер потока забьётся. Сборка проверяет это `static_assert`;
* рабочий буфер кадра minimp3 (13 КБ) вынесен в `static`: локальной переменной
  декодеру требовалось 18 КБ стека;
* эфир запускается только когда свободно не меньше 35 КБ, иначе в лог идёт
  «мало памяти под эфир» вместо перезагрузки посреди ответа;
* команда приходит раньше подтверждения, а в этот момент куча занята разбором
  ответа — поэтому эфир откладывается и стартует, когда подтверждение отзвучало.

Каталог станций для устройства короче браузерного и живёт на сервере
(`SpeakerMedia.cs`): там только MP3-станции, и для них указан HTTP-адрес.

**Активация — только по слову-активатору.** Появление звука состояние не
меняет: колонка слышит комнату постоянно. Когда сервер подтвердил обращение,
вся лента вспыхивает синим на две секунды, и только потом включается «слушаю».
Звук при этом всё равно уходит на распознавание — иначе сервер не поймёт, что
обращение было.

| Событие с сервера | Что показывает колонка |
|---|---|
| `EVENT {kind: "wake"}` | вся лента синим 2 с, затем «слушаю» |
| `EVENT {kind: "thinking"}` | «думаю» |
| `EVENT {kind: "voice", v}` | «говорю»: рот по уровню речи из браузера |
| `SPEECH_BEGIN` | «говорю»: звук идёт из динамика колонки |
| `SPEECH_END` | простой |

Рот ведётся по **реальному аудиопотоку**, а не по состоянию: из динамика — по
уровню воспроизведения (`AudioPipeline::outputLevel`), из браузера — по
огибающей той же записи, которую сервер считает и присылает 25 раз в секунду.
Поэтому рот двигается весь ответ, от первого слова до последнего.

| Состояние | Уши | Рот |
|---|---|---|
| Загрузка | белые точки с кончиков сходятся к центру | вспыхивает голубым огоньком |
| Ждёт кнопку | синее дыхание | тихое синее дыхание |
| Ищу телефон | синяя искра от рта к виску | синее дыхание |
| Простой | белое с пастельными переливами | спокойное дыхание |
| Слушаю | бирюза, яркость по громкости | `0001000`, без реакции на человека |
| Думаю | фиолетовая искра | медленное фиолетовое дыхание |
| Говорю | ровная зелень | форма по громкости, по центру |
| Нет сервера | синяя искра | тлеет |
| Ошибка | красное дыхание | тихое красное дыхание |
| Звонок | стробоскоп | стробоскоп |
| Разговор | ровная зелень | форма по громкости, по центру |
| Микрофон выключен | красное дыхание | почти закрыт |

Пока колонка говорит, микрофон **остановлен**: иначе она слышит саму себя,
отправляет свою речь на распознавание и отвечает на неё. Захват возвращается
после `SPEECH_END`.

Рот повторяет **только голос агента**: уровень берётся из воспроизводимого
звука (`AudioPipeline::outputLevel`). Микрофон к рту не подключён — иначе он
дёргался бы от голоса человека, эха и разговоров в комнате. Когда агент молчит,
рот просто дышит.

Микрофон двигает **уши**: в состоянии «слушаю» они светятся тем ярче, чем громче
звук в комнате, — это и есть «ухо ловит звук». Два уровня живут раздельно:
`Ui::setVoiceLevel` (голос агента) и `Ui::setHearingLevel` (микрофон).

Вступительная сцена не обрывается сменой состояния: новое состояние ждёт её
конца и применяется после голубого огонька. Кадр выводится 30 раз в секунду,
и фаза анимации двигается вместе с кадром. Иначе скорость переливаний
зависела бы от загрузки главного цикла.

Питание макета — **3.3 В** от платы: уровень данных ESP32 совпадает с лентой
без согласователя. Потолок яркости 220 из 255, ток около 0.45 А. Для полной
яркости ленту питают от 5 В, а линию данных заводят через 74HCT125 или
диодную развязку (1N4148 + 1 кОм к +5 В).
