RazdoruNET/DED_CORE_SPEAKER/docs/08-pairing-ux.md

# Сопряжение колонки: как это делает человек

Документ описывает полноценный пользовательский путь: что делает браузер, что
колонка, что платформа. Протокол и модель угроз — в
[07-pairing-security.md](./07-pairing-security.md).

## Кто участвует

| Сторона | Роль |
|---|---|
| Колонка | Отдаёт свой ключ и challenge, принимает зашифрованные настройки |
| Сайт (браузер) | Ведёт диалог, вызывает API, шифрует кадр, пишет его по Bluetooth |
| Платформа | Проверяет код, подписывает grant, выдаёт одноразовый токен |

Отдельного приложения и отдельного файла настроек нет: всё делает страница.

## Предусловия

* Человек вошёл в аккаунт — иначе позвать API нечем.
* Колонка в режиме привязки: **удержание кнопки 5 секунд**. Автоматически окно
  не открывается никогда, поэтому привязать колонку удалённо нельзя.
* Под рукой код с наклейки на корпусе.

## Экран привязки

Пользователь заполняет:

| Поле | Откуда | Примечание |
|---|---|---|
| Код с наклейки | наклейка на корпусе | обязательное |
| Wi-Fi | **выбор из списка, который отдаёт колонка** | см. ниже |
| Пароль Wi-Fi | вводит человек | не сохраняется на сервере |
| Название и комната | вводит человек | необязательные |

### Почему сеть выбирается из списка

Браузер не умеет перечислять Wi-Fi сети. Если просить SSID вручную, человек
ошибается в написании, и колонка молча не подключается — самая частая жалоба
у таких устройств.

Поэтому колонка в режиме привязки **сама сканирует эфир** и отдаёт список
сетей по отдельной BLE-характеристике в виде JSON: `ssid`, `rssi`, `secure`.
Сайт показывает выпадающий список, отсортированный по силе сигнала. Пароль
человек вводит только если сеть не открытая.

Сканирование запускается по чтению характеристики и работает не дольше
нескольких секунд: держать радио занятым во время привязки нельзя.

## Шаги

1. **Человек** удерживает кнопку 5 секунд. Колонка мигает и пищит, начинает
   рекламу по Bluetooth.
2. **Сайт** по кнопке «Подключить» открывает выбор устройства. Web Bluetooth
   показывает только устройства с нашим UUID сервиса, поэтому списка «всех
   Bluetooth-устройств вокруг» человек не видит.
3. **Сайт** читает характеристику сведений: идентификатор, открытый ключ,
   `challenge`, версию прошивки.
4. **Сайт** читает список Wi-Fi сетей и показывает его человеку.
5. **Сайт** отправляет на платформу `pair/claim`: код с наклейки, идентификатор
   колонки, её открытый ключ и `challenge`.
6. **Платформа** проверяет код (сравнение хешей за постоянное время), убеждается,
   что колонка не привязана к другому аккаунту, и возвращает **подписанный
   grant** с одноразовым токеном на 10 минут.
7. **Сайт** шифрует на общем секрете ECDH кадр: SSID, пароль, адрес платформы,
   название, комнату и сам grant. Пишет его по Bluetooth кусками.
8. **Колонка** расшифровывает, проверяет подпись и совпадение `challenge`,
   сохраняет настройки и перезагружается.
9. **Колонка** подключается к платформе по WSS и в первом кадре предъявляет
   одноразовый токен. Платформа меняет его на долговременный ключ устройства и
   только теперь закрепляет владельца.
10. **Сайт** показывает колонку в списке устройств. Если она не появилась за
    минуту — предлагает проверить пароль Wi-Fi.

## Что видит человек при отказах

| Ситуация | Сообщение | Что делать |
|---|---|---|
| Неверный код | «Код не подходит» | проверить наклейку |
| Колонка уже привязана к другому аккаунту | «Колонка привязана к другому аккаунту» | прежний владелец отвязывает её |
| Прошло больше 10 минут | «Время привязки истекло» | нажать кнопку заново |
| Колонка не отвечает по Bluetooth | «Не удалось подключиться» | подойти ближе, нажать кнопку заново |
| Пароль Wi-Fi неверный | «Колонка не подключилась к сети» | ввести пароль заново |
| Нет поддержки Bluetooth | «Нужен Chrome или Edge» | открыть в поддерживаемом браузере |

Ни на один отказ сайт не отвечает «нет такой колонки»: иначе перебором кодов
можно выяснить, какие устройства существуют.

## Повторная привязка и смена владельца

* Пока колонка привязана, окно Bluetooth открывается только удержанием кнопки,
  и колонка **отвергает** новую привязку сама.
* Прежний владелец отвязывает колонку в аккаунте. Это снимает отпечаток ключа
  устройства, поэтому следующая привязка требует и код с наклейки, и физического
  доступа к колонке.
* Если колонку украли — владелец помечает её как украденную. Это необратимо:
  ключ не снимается, привязать устройство к другому аккаунту нельзя.

## Ограничения браузеров

Web Bluetooth работает в Chrome и Edge на компьютере, в Chrome на Android и в
приложениях на Chromium. **Safari и Firefox не поддерживают его вовсе**, а на
iOS ограничение системное — там нужен отдельный клиент.

Поэтому страница привязки сразу проверяет `navigator.bluetooth` и, если его нет,
показывает понятное объяснение вместо кнопки, которая не работает.

Требования к контексту: HTTPS и действие человека (нажатие). Автоматически
запустить поиск устройства нельзя — это защита браузера, а не наше решение.

## Чего в первой версии нет

* QR-код вместо наклейки — код короче и его проще ввести.
* Передача списка сетей по Wi-Fi (SoftAP) — остаётся запасным вариантом, если
  Web Bluetooth окажется недоступен у части людей.
* Групповая привязка нескольких колонок одним действием.
