RazdoruNET/DED_CORE_SPEAKER/docs/04-hardware-bom.md

# Железо: состав, распиновка, ограничения

## Что реально подключено (замерено esptool)

```
Chip is ESP32-D0WD-V3 (revision v3.1)
Features: WiFi, BT, Dual Core, 240MHz, VRef calibration in efuse
Crystal 40MHz          MAC 48:af:f3:db:f9:04
Detected flash size: 4MB
Порт: /dev/cu.usbserial-0001 (CP2102)
Flash voltage set by a strapping pin to 3.3V
```

Это классический ESP32: **520 КБ SRAM, без PSRAM, 4 МБ флеша**. Модуль
`ESP32-WROOM-DA` (две PCB-антенны, переключение по качеству сигнала — в квартире
со множеством стен это заметно помогает).

Важно: 4 МБ, а не 8. Настройка идёт по Bluetooth, поэтому фронта на флеше нет
вовсе — освободившееся место уходит на два полноценных OTA-слота (1664 КБ).

## BOM

Цены ориентировочные, за штуку при мелкой партии.

| # | Узел | Модель | Кол-во | Цена, $ | Зачем именно так |
|---|---|---|---|---|---|
| 1 | Модуль | ESP32-WROOM-DA (4 МБ) | 1 | 5.0 | уже есть; две антенны |
| 2 | Микрофоны | **INMP441** (или ICS-43434) | 2 | 0.2 | цифровой I2S, не ловит наводки; INMP441 в разы дешевле, для прототипа разницы на слух нет |
| 3 | Усилитель | MAX98357A, **с выведенным пином SD** | **2** | 1.8 | I2S, 3.2 Вт; два модуля — на два динамика (dual mono), SD выбирает канал |
| 4 | Динамик | 3″ 4 Ω 5 Вт | **2** | 3.0 | по одному на усилитель; параллелить на один нельзя — 2 Ω вне паспорта |
| 5 | Датчик климата | SHT40 | 1 | 1.2 | ±1.5 % RH, ±0.2 °C |
| 6 | Датчик света | VEML7700 | 1 | 1.0 | lux без калибровки, I2C |
| 7 | Присутствие | LD2410C (ммВолна) | 1 | 2.5 | видит человека, не камеру |
| 8 | ИК-приёмник | TSOP38238 | 1 | 0.4 | обучение пульту |
| 9 | ИК-светодиод | 940 нм, 2 шт | 2 | 0.2 | дальность по комнате |
| 10 | Транзистор ИК | S8050 + резистор | 2 | 0.1 | 200 мА в импульсе |
| 11 | Лента LED | WS2812B, **17 шт**, U-образно по низу: 5 + 1 + 5 + 1 + 5 | 1 | 1.5 | язык состояний: цвет и движение фазы агента |
| 11a | Согласователь | 74HCT125 (3.3 → 5 В данных) | 1 | 0.2 | при 5 В питания ESP32 не добивает логическую единицу |
| 12 | Кнопки | тактовые 6×6 | 3 | 0.3 | действие, громкость +/− |
| 13 | Тумблер mute | MSK-12C02 | 1 | 0.4 | **рвёт питание микрофонов физически** |
| 14 | Питание | HLK-PM01 5 В 3 Вт + DC-DC **5 В 4 А** | 1 | 4.0 | от сети; 4 А — два усилителя плюс лента (пик около 2.5 А) |
| 15 | Обвязка | конденсаторы 470 µF **×2** + 100 nF, резисторы, разъёмы | — | 1.5 | по конденсатору у каждого усилителя: просадка при TX Wi-Fi |
| | **Итого прототип** | | | **≈ 25** | без корпуса и печатной платы |
| 16 | Корпус | фанера/ABS, ФИ-порт | 1 | 8–15 | акустика важнее электроники |
| 17 | Плата | 2 слоя, 100×80 мм | 5 шт | 2/шт | при партии от 5 |

## Выходной тракт: чем заменить MAX98357A

MAX98357A — это I2S-усилитель со встроенным ЦАП: три провода и всё. Если его
доставка долгая, «TDA» сам по себе не подойдёт: любой TDA/PAM/LM — это
**аналоговый** усилитель, а ESP32 отдаёт **цифровой I2S**. Нужен ЦАП между ними.

| Вариант | Что купить | Качество | Задержка доставки | Цена, ₽ |
|---|---|---|---|---|
| **A. I2S-ЦАП + аналоговый усилитель** (рекомендую) | PCM5102A (или UDA1334A) + TDA2822M / PAM8403 | 16 бит, чисто | обычно 1–3 дня | 300 + 100 |
| B. I2S-усилитель | MAX98357A | 16 бит, минимум деталей | долго | 200 |
| C. Встроенный ЦАП ESP32 + усилитель | только усилитель (TDA2822M / PAM8403) | **8 бит**, шипит | 0 (есть на плате) | 100 |
| D. ШИМ + RC-фильтр + усилитель | усилитель + 2 резистора, 2 конденсатора | 8–10 бит, хуже C | 0 | 20 |

**Почему не «просто TDA».** TDA2822M ждёт аналоговый сигнал 0.3–1 В. ESP32 без
ЦАП может отдать только цифру (I2S) или 8-битный ЦАП на GPIO25/26. Поэтому во
всех вариантах кроме B нужен ЦАП — внешний или встроенный.

**Вариант A — как собрать**

```
ESP32 GPIO25 (BCLK) → PCM5102A BCK
ESP32 GPIO26 (LRCK) → PCM5102A LRCK
ESP32 GPIO27 (DIN)  → PCM5102A DIN
PCM5102A SCK → GND, FMT → GND, DEMP → GND, XSMT → 3.3 В
PCM5102A OUTL/OUTR → делитель 10 кОм + 10 кОм → вход TDA2822M
TDA2822M выход → динамик 4 Ω
```

Делитель нужен потому, что PCM5102A выдаёт до 2.1 В действующего значения, а
TDA2822M рассчитан на 0.3–1 В: без него усилитель захлёбывается и хрипит.

**Вариант C — без покупки ЦАП.** Прошивка умеет отдавать звук через встроенный
ЦАП ESP32: `pio run -e esp32da_dac`. Ограничения честные: 8 бит (слышимый шум),
и встроенный ЦАП живёт только на I2S0 — микрофон в этом режиме переезжает на
I2S1. Годится, чтобы проверить усилитель и динамик, но не чтобы оценивать звук.

**Усилители, доступные в местных магазинах**

| Микросхема | Питание | Мощность | Замечания |
|---|---|---|---|
| TDA2822M | 3–15 В | ~1 Вт на 4 Ω при 5 В | класс AB, не шумит по Wi-Fi, дешёвый, идеален для речи |
| PAM8403 (плата) | 5 В | 3 Вт на 4 Ω | класс D, требует хорошего питания и коротких проводов к динамику |
| LM386 | 5–12 В | 0.5 Вт | простой, но шумный и тихий — только для теста |
| TDA2030A | ±12 В | 15 Вт | нужен двуполярный источник, для финального корпуса |
| TDA7297 (плата) | 12 В | 2×15 Вт | для «хорошего звука» на динамике 4″ |

Для финальной сборки с нормальной акустикой правильная пара — **PCM5102A +
TDA7297** (12 В) или **TAS5805M** (I2S-вход, DSP, без внешнего ЦАП, но дороже
и требует своей платы).

### Подключение MAX98357A: один динамик 4 Ω

MAX98357A — моно-усилитель класса D с I2S-входом: цифра идёт с ESP32 напрямую,
внешний ЦАП не нужен. Прошивка уже собирается под этот тракт по умолчанию —
никаких флагов для выхода добавлять не нужно (встроенный 8-битный ЦАП — это
отдельная сборка `esp32da_dac`, для усилителя она не нужна).

| Вывод модуля | ESP32-WROOM-DA (`esp32da`) | ESP32-S3 N16R8 (`esp32s3`) |
|---|---|---|
| `VIN` | **5 В** (не 3.3 В) | **5 В** (не 3.3 В) |
| `GND` | GND | GND |
| `LRC` (WS) | **GPIO26** | **GPIO16** |
| `BCLK` | **GPIO25** | **GPIO15** |
| `DIN` | **GPIO27** | **GPIO17** |
| `GAIN` | в воздухе — 9 дБ | в воздухе — 9 дБ |
| `SD` | в воздухе — моно-микс (L+R)/2 | в воздухе — моно-микс (L+R)/2 |
| `OUT+` / `OUT−` | динамик 4 Ω | динамик 4 Ω |

Пины совпадают с `pins::SPK_*` в `config/AppConfig.h`; менять их в одном месте
нельзя — разводка и прошивка должны сходиться.

**Питание и монтаж:**

* `VIN` — только 5 В. От 3.3 В усилитель работает, но выдаёт около ватта:
  громкости для комнаты не хватит.
* Конденсатор **470 мкФ** плюс **100 нФ** между `VIN` и `GND` рядом с модулем.
  Просадка при передаче Wi-Fi слышна как треск на громком звуке.
* Питание от USB-порта платы годится только для проверки на малой громкости:
  пик 3.2 Вт — это около 0.9 А, и порт просаживается. Для полной мощности —
  отдельные 5 В / 2 А с общей землёй.
* Провода к динамику — короче 15 см и свитой парой: выход импульсный, длинные
  провода ловят наводки на микрофоны. Провода I2S — тоже короче 15 см.
* Земля динамика не соединяется с землёй платы: выход **мостовой (BTL)**, оба
  вывода динамика «горячие». Замыкание любого из них на GND выводит усилитель
  из строя.
* Пищалка остаётся на своём выводе (GPIO23 у DA, GPIO21 у S3) и к усилителю не
  подключается: это отдельный выход с ШИМ, а не динамик.
* Динамик 4 Ω 5 Вт подходит с запасом: при 5 В MAX98357A отдаёт до **3.2 Вт**
  на 4 Ω (10 % искажений), то есть половину паспортной мощности динамика.
  Больше из одного модуля не выжать — это предел микросхемы, а не динамика.
* Полярность динамика с одним модулем не важна; при двух динамиках `+`/`−`
  соблюдать, иначе на низах они гасят друг друга.

**Проверка до подключения к серверу.** Стендовые сборки играют три тона
(440, 1000, 2000 Гц) сразу после старта, пищалка при этом молчит:

```
pio run -e esp32da_spk -t upload     # классический ESP32
pio run -e esp32s3_spk -t upload     # ESP32-S3
```

В логе — `[spk] проверка выхода: 440, 1000, 2000 Гц` и `[spk] проверка выхода
закончена`. Тоны играют один раз, повторить — кнопкой RST. Тишина означает одно
из трёх: `SD` притянут к земле (усилитель выключен), перепутаны `DIN`/`BCLK` или
питание не доходит. Хрип и треск — просадка питания, лечится конденсатором и
более толстыми проводами.

## Стерео и микрофоны: что эта плата умеет, а что нет

### Два динамика на MAX98357A

MAX98357A — моно-усилитель, поэтому на два динамика нужно **два модуля**. Оба
подключаются к одной шине I2S (BCLK, LRCK, DIN общие), а канал выбирается пином
**SD_MODE**: левый, правый или моно-микс (L+R)/2.

| Требование | Почему |
|---|---|
| На модуле должна быть **выведена площадка SD** | на дешёвых платах SD жёстко притянут к питанию — оба модуля играют левый канал |
| Динамики **не параллелить** на один усилитель | 2 Ω выходит за паспорт MAX98357A: перегрев и отключение |
| Питание **5 В / 4 А** | два усилителя по 3.2 Вт плюс лента дают пик около 2.5 А; запас — на просадки при TX Wi-Fi |
| Конденсатор 470 µF **у каждого** модуля | один общий не сглаживает просадку на своём участке |
| Отдельные камеры в корпусе | два динамика в общей камере гасят друг друга на низах |

#### Выбор канала на MAX98357A (проверено по документации)

Пин **SD** совмещает две функции: выключение и выбор канала. Пороги по
напряжению на SD:

| Напряжение на SD | Что на выходе |
|---|---|
| < 0.16 В | усилитель выключен |
| 0.16–0.77 В | (Left + Right) / 2 — моно-микс, **заводское значение** |
| 0.77–1.4 В | только правый канал |
| > 1.4 В | только левый канал |

Внутри стоит подтяжка **100 кОм к земле**, а на плате — резистор к Vin, который
и даёт заводской моно-микс. Поэтому просто «добавить резистор» для канала может
не хватить: подтяжку к Vin нужно либо пересилить, либо снять.

| Задача | Что сделать при питании 5 В |
|---|---|
| моно-микс (dual mono на двух динамиках) | ничего, заводское состояние |
| только левый | снять платный резистор к Vin, SD → Vin напрямую через 10 кОм |
| только правый | снять платный резистор к Vin, SD → Vin через 390 кОм |

Номиналы рассчитаны с учётом внутренних 100 кОм: 390 кОм дают около 1.0 В
(правый канал), 10 кОм — около 4.5 В (левый). После пайки проверить мультиметром
**до** подключения динамика.

Громкость задаётся пином **GAIN**: 100 кОм на GND — 15 дБ, GND напрямую — 12 дБ,
в воздухе — 9 дБ (заводское), Vin напрямую — 6 дБ, 100 кОм на Vin — 3 дБ.

Логические входы принимают **3.3–5 В**, поэтому при питании 5 В согласователь
уровней не нужен — в отличие от ленты WS2812B.

Ограничение честное: **поток сейчас моно** (`pcm16`, 16 кГц, без каналов в
объявлении кодека). Два динамика дают dual mono — громче и шире по комнате, но
не стереосцену. Настоящее стерео требует расширения протокола до двух каналов и
вдвое большего трафика; для речи это не нужно, для музыки — понадобится.

### Матричный микрофон

На классическом ESP32 матрица не заработает, и это ограничение платы, а не
денег:

| Что нужно матрице | ESP32-WROOM-DA |
|---|---|
| TDM / 4 канала I2S (ES7210 и подобные) | **нет**: `SOC_I2S_SUPPORTS_TDM` не определён (есть только `SOC_I2S_NUM=2` и `SOC_I2S_SUPPORTS_DAC=1`) |
| PSRAM для ESP-SR AFE (beamforming, AEC) | **нет**: 520 КБ SRAM |

Модуль на ES7210 отдаёт данные по TDM, а драйвер I2S в Arduino-ядре 2.0.17 для
классического ESP32 TDM не поддерживает — модуль нечем читать. Плюс сама матрица
полезна только вместе с AFE, который требует PSRAM.

**Матрицу берём вместе с S3.** В `ESP32-S3-Korvo-2` уже стоят 3 микрофона и
ES7210, распаяны и проверены Espressif.

### Референс для AEC без ES7210

Модуль ES7210 нужен ровно для одного: вернуть в цифру аналоговый сигнал с выхода
усилителя. Но этот сигнал **уже есть в цифре** — это сэмплы, отправленные в I2S.
Значит референс берётся из буфера воспроизведения, а не с отдельного АЦП.

```
2 I2S-микрофона → I2S RX ─┐
буфер воспроизведения ────┴→ AFE: [mic1, mic2, reference]
```

Это та же схема, что у Espressif (микрофоны плюс референс), только референс не
занимает канал АЦП.

**Препятствия, которые надо решить:**

| Препятствие | Решение |
|---|---|
| дрейф часов между портами: микрофоны и усилитель на разных делителях, при 100 ppm это ~60 мс за 10 минут | **full-duplex на одном порту I2S**: TX и RX делят BCLK/WS, задержка детерминирована. Флаги `I2S_MODE_TX \| I2S_MODE_RX` комбинируются |
| библиотека AEC | ESP-SR AFE (лучшее качество, нужен PSRAM и IDF-компонент) или SpeexDSP AEC (лёгкий, качество для речи приемлемое) |
| AFE работает блоками 32 мс (512 сэмплов), у нас кадр 20 мс | аккумулятор кадров на границе |

**Порядок работ, чтобы не упираться в «всё или ничего»:**

1. два микрофона и стерео-выход на одном full-duplex порту, режим half-duplex —
   прототип уже полезен;
2. кольцевой буфер воспроизведения как третий канал в AFE — эхо гасится;
3. barge-in: перебивание во время ответа.

Если шаг 2 не даст выигрыша, остаётся рабочий half-duplex с шага 1. Без AEC
нельзя перебивать колонку и нельзя говорить wake word во время музыки — для
продукта это заметная потеря, но не блокер запуска.

### Два микрофона на одной шине

Штатный путь для прототипа: два I2S-микрофона (INMP441 или ICS-43434) делят BCLK
и WS, у одного пин L/R на GND, у другого на VDD. Получается два канала I2S —
задел под определение направления и референс для эхоподавления. Прошивку под
два канала меняем, когда микрофоны приедут: сейчас читается только левый слот.

## ESP32-S3 DevKitC-1 N16R8: что на плате

Модуль проверен на железе: **ESP32-S3 (QFN56, rev v0.2), 16 МБ флеша,
8 МБ встроенной PSRAM, MAC 7c:e8:b1:b0:63:dc**, USB-мост CH343p.

| Что | Где | Для нас |
|---|---|---|
| Встроенный WS2812 | **GPIO48** (проверено перебором на живой плате) | повторяет состояние агента, виден без внешней ленты |
| Вывод **RGB-OUT** | **GPIO38**, отдельный штырёк | сюда ставится внешняя лента 17 диодов (U-образная) |
| Два USB-C | native USB (GPIO19/20) и CH343p (UART0) | прошивка и логи через CH343p, native USB свободен |
| Кнопка BOOT | GPIO0 | strapping: не занимать под наши кнопки |
| Кнопка RST | — | сброс |
| Вывод MCLK | любой свободный GPIO | нужен для ES7210, если матрица появится |

**Занятые выводы:** 26–32 (флеш), 33–37 (PSRAM), 19/20 (native USB),
43/44 (UART0), 0/3/45/46 (strapping).

**Наши выводы на N16R8:**

| Узел | GPIO |
|---|---|
| Микрофоны I2S (BCLK / WS / SD) | 4 / 5 / 6 |
| Усилитель I2S (BCLK / LRC / DIN) | 15 / 16 / 17 |
| I2C (SHT40, VEML7700) | 8 (SDA) / 9 (SCL) |
| Кнопки: действие / громкость + / − | 10 / 11 / 12 |
| Тумблер mute | 13 |
| Внешняя лента (RGB-OUT) | 38 |
| Встроенный WS2812 | 48 |
| ИК-приёмник / ИК-светодиод | 18 / 14 |

Встроенный светодиод и внешняя лента разведены по разным выводам, поэтому
работают одновременно: прошивка повторяет состояние ленты на встроенном
диоде, и на макете индикация видна ещё до подключения ленты.

**Как вывод встроенного светодиода был найден.** По схеме платы он выглядел
как GPIO38, но на этом выводе светодиод не загорался. Перебор кандидатов
(48, 47, 21, 42, 41, 40, 39, 4 — по одному ярким цветом) показал 48.
Вывод 38 на плате подписан «RGB-OUT» и предназначен для внешней ленты.

## Подключение двух INMP441 к ESP32-S3

Модуль INMP441 (круглый, 6 выводов: `GND`, `VDD`, `SD`, `L/R`, `WS`, `SCK`).
Два микрофона работают на одной шине I2S: тактовые линии общие, а данные —
на одном проводе, потому что каждый микрофон выдаёт сигнал только в свой
полутакт.

| Вывод микрофона | Куда | Примечание |
|---|---|---|
| `VDD` | **3.3 В** | не 5 В: INMP441 рассчитан на 1.8–3.3 В |
| `GND` | GND | общий с платой |
| `SCK` | **GPIO4** (BCLK) | у обоих микрофонов общий |
| `WS` | **GPIO5** | у обоих общий |
| `SD` | **GPIO6** | у обоих общий: выводы данных соединяются вместе |
| `L/R` | микрофон 1 → **GND**, микрофон 2 → **VDD** | задаёт канал: левый или правый |

Почему `SD` можно соединять: INMP441 держит выход в третьем состоянии всё
время, кроме своего полутакта. При разных `L/R` микрофоны не мешают друг
другу, и в кадре получается честная стереопара.

**Требования к монтажу:**

* провода короче 15 см — BCLK идёт на 1.5 МГц, длинные линии дают помехи;
* конденсатор 100 нФ плюс 10 мкФ по питанию **рядом с каждым** микрофоном;
* питание брать с 3.3 В платы, не с 5 В;
* если уровни сильно разные — проверить пайку `L/R`: перепутанный вывод даёт
  два микрофона в одном канале, а второй канал остаётся пустым.

**Проверка:** сборка `pio run -e esp32s3_micdiag` печатает раз в секунду
уровень (RMS) и пик каждого канала. Ноль в одном канале означает, что микрофон
не отвечает или `L/R` подключён не туда.

Измерено на живой паре INMP441 (тихая комната, сдвиг 16 бит):

| Условие | RMS | Пик |
|---|---|---|
| тишина | 20–300 | 150–500 |
| разговор, шаги | 900–3000 | 3000–7000 |
| первая секунда после включения | до 2800 | **32760 — клип** |

Всплеск в первую секунду — переходный процесс при подаче питания на микрофон.
Он **влиял на работу**: пик упирался в предел, RMS доходил до 2500, и детектор
речи срабатывал на каждом включении, отправляя мусорную фразу. Первые
25 кадров (полсекунды) теперь читаются и выбрасываются. Рабочий диапазон занимает примерно
25–30 дБ между фоном и речью, поэтому пороги VAD оставлены прежними:
`VAD_RMS_ON = 700` выше наблюдаемого фона и ниже уровня речи.

## Распиновка

Выбрана так, чтобы не занимать strapping-пины, которые мешают загрузке, и не
трогать выводы флеша (6–11).

| Узел | Сигнал | GPIO | Примечание |
|---|---|---|---|
| Микрофоны (I2S0, RX) | BCLK | 32 | |
| | WS (LRCK) | 33 | |
| | SD (данные) | 34 | вход, без подтяжки (питание мика — через подтяжку на плате) |
| Усилитель (I2S1, TX) | BCLK | 25 | |
| | LRC | 26 | |
| | DIN | 27 | |
| I2C (SHT40, VEML7700) | SDA | 21 | 4.7 кОм к 3.3 В |
| | SCL | 22 | |
| LD2410C | RX/TX | 18 / 19 | UART2, 256000 |
| Кнопка «действие» | — | 0 | встроенная BOOT, своя подтяжка |
| Громкость + | — | 39 | вход, внешняя подтяжка 10 кОм |
| Громкость − | — | 35 | то же |
| Тумблер mute | — | 36 | вход; одновременно коммутирует 3.3 В микрофонов |
| LED | DIN | 16 | 330 Ом последовательно |
| ИК TX | — | 4 | через транзистор |
| ИК RX | — | 17 | 100 нФ + 10 кОм |
| ESP-NOW | — | — | радио, выводов не нужно |
| ESP32-H2 (Zigbee, опция) | TX/RX | 13 / 14 | UART1, вторая плата в том же корпусе |

Свободны и выведены на гребёнку: 2, 12, 15, 23, 5 — под будущее (реле, второй
динамик, датчик дыма).

### Раскладка ленты: уши, разделители, рот

17 диодов идут по низу колонки буквой U и делятся по смыслу лица, а не поровну:
по краям уши (они же щёки), в середине рот, между ними погашенные разделители.
Матрица глаз появится отдельной деталью.

```
1 2 3 | 4 5 | 6 7 8 9 10 11 12 | 13 14 | 15 16 17
 уши    выкл.       рот            выкл.     уши
```

| Часть | Диодов | Роль |
|---|---|---|
| Уши | по 3 | индикация событий и отклик на звук |
| Разделители | по 2 | погашены всегда: видимая граница уха и рта |
| Рот | 7 | живёт всегда: дыхание в тишине, силомер по громкости |

`DIN` — левый кончик (диод 1), `DOUT` правого остаётся свободным. Если лента
смонтирована наоборот, это правится флагом `leds::kReversed` в
`app/LedLayout.h`, перепаивать не нужно.

## Электрика и акустика

* Пик потребления: Wi-Fi TX 240 мА + два усилителя до 650 мА на пиках у 4 Ω +
  лента до 1 А на полной яркости. Блок **5 В / 3 А минимум**.
* Рабочая схема макета: лента питается от **3.3 В** платы, данные идут напрямую
  с GPIO. Уровни совпадают, согласователь не нужен. 17 диодов при яркости
  220 из 255 берут около 0.45 А; 470 Ω в линию данных и 1000 µF по питанию
  всё равно желательны.
* Для полной яркости ленту питают от 5 В, а данные заводят через **74HCT125**:
  при 4.5–5 В без согласователя первая половина мерцает. 470 Ω последовательно
  и 1000 µF по питанию обязательны.
* 17 диодов на полной яркости — 17 × 60 мА ≈ 1 А. Программный потолок 220/255
  держит ленту в пределах 3.3-вольтового стабилизатора; полный белый на 255
  включать не стоит — это и слепящий свет, и лишний ток.
* 470 µF электролит + 100 nF керамика у усилителя, отдельная земляная звезда:
  цифровая земля не должна идти через силовую дорожку динамика.
* Микрофоны — на расстоянии **65–80 мм** друг от друга, в верхней части корпуса,
  на демпферах, акустически развязанных от динамика. Иначе корпус поёт вместе с
  динамиком, и wake word срабатывает на собственную музыку.
* Динамик в ФИ-корпусе (порт 25×60 мм) — иначе речь звучит плоско, а на 200 Гц
  корпус дребезжит.

## Тепло

Колонка работает непрерывно (wake word всегда слушает). При 25 °C в комнате
кристалл ESP32 держит 55–65 °C, в закрытом корпусе без вентиляции — до 80 °C, и
начинается троттлинг Wi-Fi. Решения: вентиляционные щели сверху-снизу,
теплоотводящая прокладка на нижнюю крышку, порог троттлинга в прошивке 75 °C.

## Бюджет памяти (классический ESP32)

| Что | RAM, КБ |
|---|---|
| свободно после Wi-Fi STA + WSS (mbedTLS 6К/4К) | 120–140 |
| Opus-энкодер (SILK 16 кГц, complexity 2) | 25–30 |
| Opus-декодер | 12–15 |
| TFLite Micro + arena wake word | 40–60 |
| преролл 0.9 с PCM16 16 кГц | 29 |
| джиттер 3×20 мс + буферы I2S DMA | 6 |
| WS-клиент и JSON | 8–16 |
| **итого** | **120–150** |

Вывод: **влезает впритык**, запаса 10–20 КБ. NimBLE добавляет 30–45 КБ, но
только на время привязки: после успешной настройки стек освобождается.

Измерено на реальной сборке: **RAM 62 292 байт (19 %)**, свободный heap после
Wi-Fi и BLE — 213 КБ.

Бюджет флеша (4 МБ): NVS 20 КБ, otadata 8 КБ, app0 1664 КБ, app1 1664 КБ,
coredump 64 КБ, storage 640 КБ. Собранная прошивка занимает **1 234 685 байт
(72.5 % слота)** — запас есть, но не для медиа-декодера.

## HDMI: почему не на этой плате

Спрашивали, можно ли добавить HDMI — на будущее, для видео. Короткий ответ: на
ESP32-S3 **видеовыхода нет вообще**, и «припаять модуль» здесь не работает.

| Что нужно для HDMI | Есть ли у S3 | Что это значит |
|---|---|---|
| MIPI-DSI / HDMI-контроллер | нет | своего видеосигнала плата не даёт |
| Параллельный RGB (LCD_CAM) | есть, 16 бит | нужен внешний передатчик RGB→HDMI (TFP410, LT8912) и кадровый буфер в PSRAM |
| PSRAM для кадрового буфера | **выключена намеренно** | включать нельзя: с ней плата падала в приёмном пути Wi-Fi (см. `05-firmware.md`) |

Реальные пути, если видео правда понадобится:

1. **ESP32-P4** — RISC-V, аппаратный H.264-декодер, MIPI-DSI, HDMI через
   DSI→HDMI-мост. Это новая плата и новая прошивка, но единственный «ESP-путь»
   с честным видео.
2. **Внешняя приставка** (Android TV, Raspberry Pi) с веб-приложением
   платформы. Колонка остаётся звуковым терминалом, картинка живёт на своём SoC.
   Дешевле, надёжнее и не тянет за собой переделку корпуса.
3. S3 + RGB→HDMI — только для статичной картинки или низкого разрешения:
   кадровый буфер некуда положить, кроме как в дефицитную внутреннюю память.

Решение проекта: **HDMI на колонке не делаем**. Колонка — терминал звука;
видео забирает устройство, у которого для этого есть SoC.

## Чего классический ESP32 не может

| Возможность | Почему | Что делать |
|---|---|---|
| Аппаратный AEC (AFE из esp-sr 2.x) | требует S3 + PSRAM | полудуплекс: микрофон закрыт, пока Лира говорит; слова «стоп» ловит отдельный KWS |
| Полный дуплекс-интерком | следствие отсутствия AEC | интерком полудуплекс, по VAD или кнопке |
| Декодирование музыки + речь одновременно | нет PSRAM, ~120 КБ заняты трактом | медиа — отдельным режимом (речь выгружается) |
| Стриминговый STT-буфер на борту | не нужен, STT на сервере | — |

## Путь на ESP32-S3

Продуктовая плата: **ESP32-S3-WROOM-1 N16R8** (16 МБ флеша, 8 МБ PSRAM),
+ ES7210/ES8311 (аудиокодек с AEC-трактом) вместо MAX98357A.

Что меняется:

| Что | Было (DA) | Стало (S3) |
|---|---|---|
| Wake word | TFLM MicroWakeWord | ESP-SR WakeNet + AFE (лучше на эхе и шуме) |
| AEC | нет | есть → полный дуплекс, barge-in без «стоп-слов» |
| Медиа | отдельный режим | одновременно с речью |
| Привязка | BLE, только в окне | BLE + числовое сравнение на экране |
| Флеш | 2×1.4 МБ + 1.2 МБ | 2×3 МБ + 4 МБ fs, встроенный фронт |
| Корпус | тот же | тот же |

Прошивка уже разделена профилями (`esp32da` / `esp32s3`): код общий, различаются
`DEVICE_PROFILE_*`, набор задач и аудио-бэкенд. Печатные платы не совместимы по
посадке — это отдельная ревизия, но схема и BOM переиспользуются.
