RazdoruNET/DED_CORE_SPEAKER/stl/Body2.stl

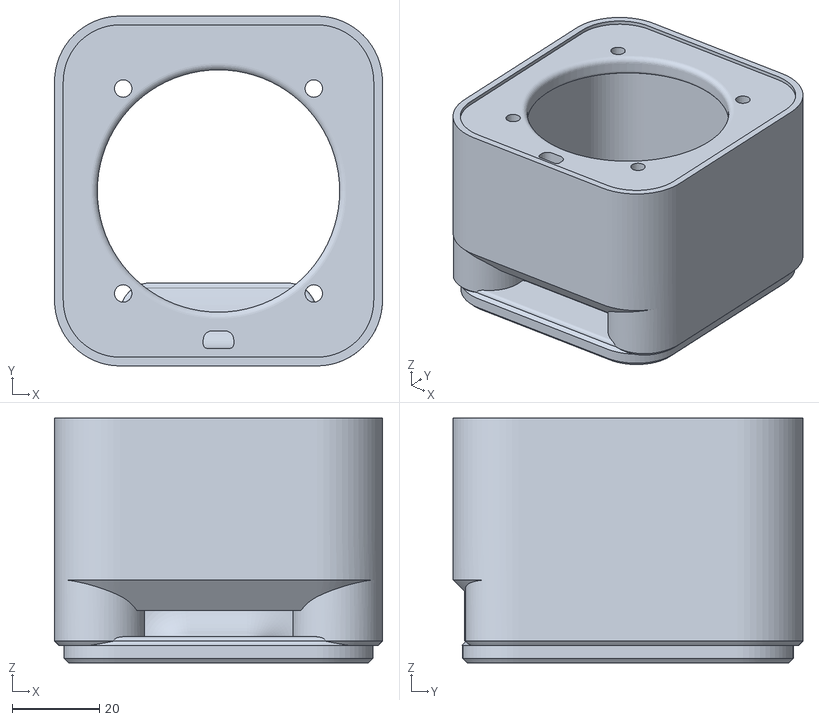
[picture p1: CAD file, 2026-11-07]
stl/Body2.stl
75.0 x 80.0 x 56.0
