RazdoruNET/DED_CORE_SPEAKER/firmware/src/app/Trace.h

#pragma once

#include <Arduino.h>

// Короткий журнал «что происходило перед сбоем».
//
// Повреждение кучи обнаруживается позже, чем случается: писатель уже ушёл.
// Поэтому храним последние действия в маленьком кольце и печатаем их в момент,
// когда проверка целостности кучи впервые провалилась.
namespace trace {

void mark(const char* what);

/// Проверка целостности кучи: при первом провале печатает кольцо и
/// перезагружает плату — дальше работать с испорченной кучей нельзя.
void checkHeap();

}  // namespace trace
