RazdoruNET/DED_CORE_SPEAKER/(commit log)

2026-11-07 DED CORE SPEAKER: прошивка, протокол и документация
    Умная колонка на ESP32: тонкий терминал платформы, привязка по коду с
    наклейки, защищённый канал, автономные умения.
    - прошивка: ESP32-WROOM-DA и ESP32-S3 (PlatformIO), I2S/VAD, BLE-привязка,
    бинарный WebSocket, mute, серийная сборка с требованием flash encryption;
    - привязка: P-256 + ECDH -> HKDF -> AES-256-GCM, подписанный сервером grant,
    кадр версии 2 с кодом с наклейки; векторы вывода ключа в t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
    [Body2.stl, partitions_speaker.csv, partitions_speaker_s3.csv]
2026-11-07 README: описание прототипа, сборка и структура репозитория
2026-11-08 Security: цепочка доверия только CA платформы, требования к ключу подписи
    Колонка по умолчанию доверяет только SPEAKER_ROOT_CA_PEM: публичные корни рядом с пином расширяли доверие до любого публичного CA, и подделать сервер мог тот, кто получит у него сертификат на наш домен — а в HELLO уходит ключ устройства. Публичные корни теперь под явным флагом SPEAKER_ALLOW_PUBLIC_ROOTS (только стенд). В docs/09-production-security.md д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
2026-11-08 docs+ci: пиннинг CA в README, gitleaks и сборка в CI
    README: безопасность канала уточнена — доверие только CA платформы, публичные корни под флагом SPEAKER_ALLOW_PUBLIC_ROOTS и только для стенда. CI: gitleaks по всей истории, проверка запрещённых файлов (ключи, Secrets.h, .dev/), сборка esp32s3_prod на заглушках Secrets.example.h.
2026-11-08 ci: Dependabot для экшенов
2026-11-09 Колонка: лицо из ушей и рта, шкалы микрофонов, речь агента, стабильность связи
    Лицо и свет:
    * лента делится по смыслу: уши 1–3 и 15–17, разделители 4–5 и 13–14 (погашены
    всегда), рот 6–12;
    * рот двоичный: покой — один средний диод, речь — симметричные формы по
    громкости голоса агента, между формами яркость подтягивается за 3–4 кадра;
    * простой изредка «оживает» двумя анимациями (проезд трой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
2026-11-09 Колонка 0.2.0: встроенные обращения, офлайн-набор и общая база с гарнитурой
    - три встроенных слова-активатора «Лира», «Джарвис», «Колонка»
    - таблица офлайн-команд домашней колонки (свет — заглушка)
    - сборка гоночной гарнитуры esp32s3_intercom в общей базе
    - README: пути репозитория, план против реализации, версия 0.2.0
2026-11-09 README: ссылка на сайт dedbox.pro в поддержке
2026-11-09 Колонка 0.2.2: безопасность привязки, преролл и проверка голоса
    - версия кадра привязки определяется сервером и входит в подписанный grant;
    сайт берёт её из grant, а не из неаутентифицированной характеристики BLE
    - преролл сбрасывается при остановке захвата и не пишется при выключенном
    микрофоне: голос агента не попадает в команду, mute больше не течёт
    - проверка голоса при нехватке кадров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
2026-11-10 ci: закрепить платформу espressif32@7.0.1
    `platform = espressif32` без версии ставит свежий espressif32: в CI это 8.0.0 с
    Arduino core 3.3.12, где убраны ledcSetup/ledcAttachPin и mbedtls_sha256_*_ret.
    Из-за этого джоба «Сборка прошивки» падала на каждом коммите.
    Проверено на прошивке: esp32s3_prod собирается с закреплённой версией.
2026-11-10 ci: сборка прошивки блокирует merge
    Платформа закреплена (espressif32@7.0.1), сборка зелёная на всех окружениях,
    поэтому обходной continue-on-error больше не нужен: красная сборка теперь
    останавливает PR, а не висит молча крестиком на каждом коммите.
2026-11-14 Колонка: усилитель MAX98357A, эфир и музыка с самой колонки
    Собрано всё, что сделано на прототипе с момента прошлого обновления этого
    репозитория.
    Звук и железо:
    * MAX98357A на обеих платах: DA — 25/26/27, S3 — 15/16/17. Стендовые сборки
    esp32da_spk и esp32s3_spk играют три тона при старте, чтобы проверка пайки не
    зависела от сети.
    * хрип в речи побеждён: очередь воспроизведения 40 кусков с праймингом,
    громкост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
2026-11-14 Колонка: отложенный эфир отменяется новой командой
    Если команда пришла во время речи или при нехватке памяти, эфир откладывался
    до конца ответа. Новый media.stream или удачный media.play его не отменял, и
    через секунду после речи срабатывал старый адрес — он рвал только что начатый
    поток и включал прошлую станцию.
    В README добавлен раздел про два репозитория: эта папка — копия содержимого
    реп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
